szjuan/Micro_1/CódigosSistemaFinal/PreInforme_1__Freno_Pinza_.pdf

# Pre Informe (Freno Pinza)

Proyecto de Diseno en Mecatr ˜ | ónica

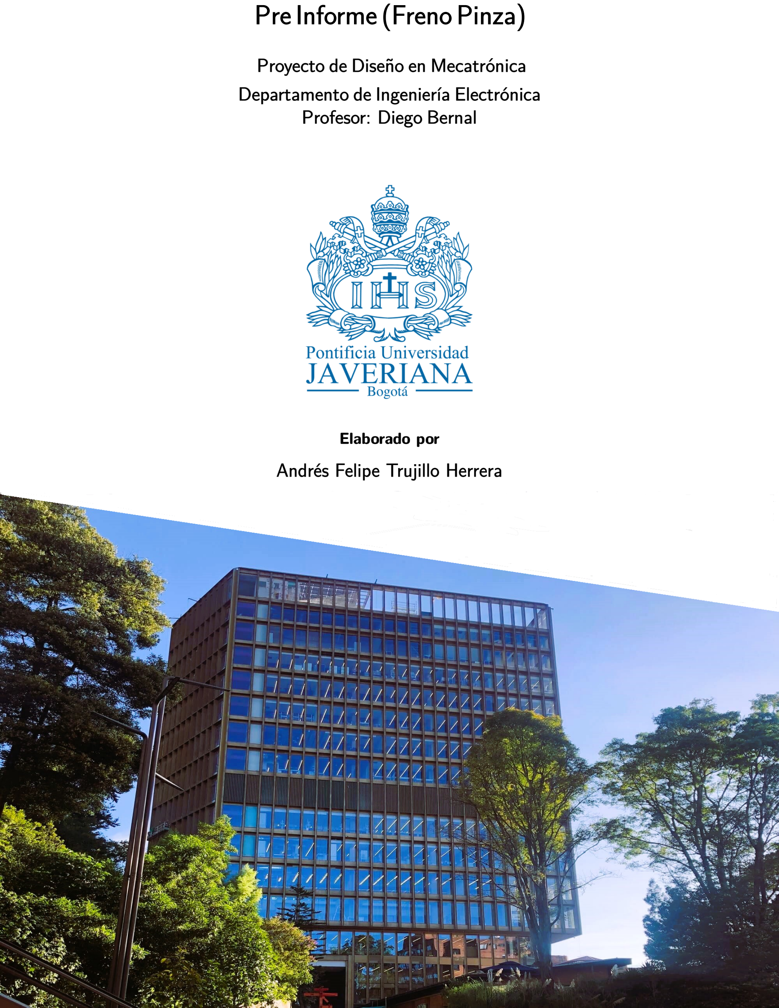
[picture p1: page 1]

## Departamento de Ingeniería Electrónica Profesor: Diego Bernal

Elaborado por

## Andrés Felipe Trujillo Herrera

Pre Informe (Freno Pinza)

## 1 | Introducción

Los motores Brushless DC (BLDC) son utilizados en diferentes aplicaciones mecatrónicas debido a su eficiencia, buena respuesta dinámica y bajo desgaste mecánico. Sin embargo, para seleccionar y utilizar correctamente uno de estos motores es necesario conocer su comportamiento ante diferentes condiciones de operación, especialmente cuando se aplican cargas sobre su eje.

En este proyecto se busca caracterizar un motor 57BLDC mediante la obtención de su modelo matemático y el análisis de variables como la velocidad, la corriente, el torque, la potencia y la eficiencia. Inicialmente, el comportamiento del motor será representado mediante un modelo electromecánico y un diagrama de bloques, los cuales serán implementados en Simulink para observar la respuesta del sistema ante distintos valores de carga.

Posteriormente, se diseñará un sistema experimental que permita aplicar torque resistente de forma controlada. Para ello, se propone un freno de disco tipo pinza, el cual generará una fuerza de fricción opuesta al movimiento del motor. La reacción producida por el frenado será medida mediante un sistema basado en galgas extensiométricas, permitiendo determinar el torque aplicado durante cada prueba.

1.1 | Planteamiento del problema

Para determinar las características reales de un motor no es suficiente con ponerlo en funcionamiento sin carga, ya que su velocidad, corriente y eficiencia cambian cuando aumenta el torque requerido en el eje. Por esta razón, se necesita un sistema que permita aplicar diferentes niveles de carga de manera gradual, estable y repetible, sin comprometer la integridad del motor ni la seguridad del montaje.

Además de aplicar la carga, es necesario medir correctamente el torque generado por el sistema de frenado y relacionarlo con las demás variables eléctricas y mecánicas del motor. La señal obtenida mediante una galga extensiométrica es de baja amplitud, por lo que requiere una etapa de acondicionamiento, adquisición y procesamiento antes de poder ser interpretada.

También se requiere una forma organizada de transmitir y visualizar los datos obtenidos durante las pruebas. Por esta razón, el proyecto debe integrar el sistema mecánico de frenado con un sistema electrónico y de comunicación que permita consultar las mediciones en tiempo real desde otro computador.

1.2 | Solución propuesta

Como solución se planteó el diseño de un banco de pruebas para caracterizar el motor 57BLDC mediante un sistema de frenado mecánico tipo pinza. El disco se acopla al eje del motor y la carga se regula manualmente mediante un mecanismo roscado que aproxima ambas partes de la pinza, aumentando progresivamente la fuerza de fricción y el torque resistente.

El torque se determina a partir de la reacción mecánica de la pinza sobre una celda de carga instrumentada con galgas extensiométricas. La señal es adquirida mediante un módulo HX711 y procesada por un ESP32, mientras que la velocidad se obtiene a partir del pin S del driver ZS-X11H. Ambas variables son enviadas mediante MQTT hacia un broker y posteriormente recibidas por un programa desarrollado en Python.

De forma paralela, Python se comunica con la fuente programable mediante Keysight IO Libraries y PyVISA para obtener los valores de voltaje y corriente y controlar las condiciones de alimentación. De esta forma se centralizan las variables:

V, | I, | n, | Fm, | (1.1)

a partir de las cuales se calculan la velocidad angular, el torque de carga, la potencia y la eficiencia. Los datos se almacenan continuamente para analizar tanto el comportamiento transitorio como las condiciones de estado estacionario y generar posteriormente las curvas características del motor.

1.3 Alcance del proyecto | Pre Informe (Freno Pinza)
1.3 | Alcance del proyecto

El proyecto comprende el modelado matemático equivalente del motor 57BLDC, su representación mediante un diagrama de bloques y la simulación de su respuesta en MATLAB ante variaciones de voltaje y torque de carga. También incluye el diseño mecánico del sistema de frenado tipo pinza, los cálculos principales, la selección de materiales y la elaboración de los planos de fabricación.

Además, se plantea el sistema de medición de fuerza mediante una celda de carga, un módulo HX711 y un ESP32, junto con la obtención de la velocidad desde el driver ZS-X11H. Las variables eléctricas se adquieren desde la fuente programable mediante PyVISA, mientras que los datos del ESP32 se transmiten por MQTT hacia un computador para su procesamiento en Python.

Finalmente, se establece el protocolo de medición necesario para obtener las curvas características y analizar tanto el comportamiento estacionario como transitorio del motor, dejando definida la base para la posterior fabricación, calibración y validación experimental del banco de pruebas.

## 2 | Objetivos

2.1 | Objetivo general

Diseñar un banco de pruebas para la caracterización de un motor 57BLDC, utilizando un sistema de frenado tipo pinza que permita aplicar diferentes niveles de torque resistente y medir las principales variables eléctricas y mecánicas del sistema para analizar su comportamiento en estado estacionario y transitorio.

2.2 | Objetivos específicos

■ Determinar los parámetros eléctricos y mecánicos necesarios para construir el modelo matemático equivalente del motor 57BLDC.

■ Representar el comportamiento dinámico del motor mediante sus ecuaciones, un diagrama de bloques y simulaciones desarrolladas en MATLAB ante variaciones de voltaje y torque de carga.

■ Diseñar el sistema mecánico de frenado tipo pinza, incluyendo el disco, el mecanismo de ajuste, los soportes y el sistema de medición del torque.

■ Implementar y calibrar el sistema de medición de fuerza mediante una celda de carga, un módulo HX711 y una ESP32, con el fin de obtener el torque resistente aplicado al motor.

■ Obtener la velocidad del motor a partir del driver ZS-X11H y adquirir las variables eléctricas de la fuente programable mediante Keysight IO Libraries y PyVISA.

■ Desarrollar un sistema de adquisición y procesamiento en Python que integre los datos recibidos mediante MQTT y PyVISA, permitiendo calcular torque, velocidad angular, potencia y eficiencia.

■ Establecer un protocolo experimental para obtener las curvas características del motor y analizar su respuesta bajo diferentes condiciones de alimentación y carga de manera segura y repetible.

## 3 | Marco teórico

3.1 | Motores de corriente continua

Los motores de corriente continua, también conocidos como motores DC, son máquinas eléctricas que convierten energía eléctrica en movimiento rotacional. Su funcionamiento se basa en la interacción entre un campo magnético y la corriente que circula por los conductores del motor, produciendo una fuerza electromagnética que genera torque sobre el eje [1].

En un motor DC convencional, el estator genera el campo magnético y el rotor o armadura corresponde a la parte giratoria. La conmutación de la corriente se realiza mecánicamente mediante escobillas y un conmutador, permitiendo mantener el giro del rotor en una misma dirección.

3.2 Motores Brushless DC | Pre Informe (Freno Pinza)

Entre sus componentes principales se encuentran:

■ El estator, encargado de producir el campo magnético.

■ El rotor o armadura, que corresponde a la parte giratoria.

■ El eje, encargado de transmitir el movimiento mecánico.

■ Las escobillas y el conmutador, utilizados para realizar la conmutación eléctrica.

■ Los rodamientos, que permiten el giro del eje con menor fricción.

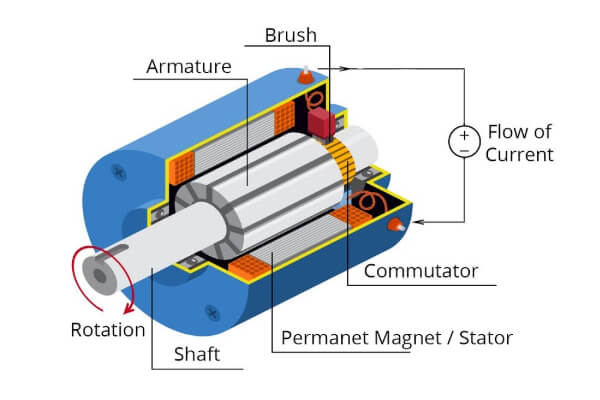
[picture p2: figure]

Figure 3.1: Partes principales de un motor de corriente continua.

Durante el funcionamiento del motor existe una relación directa entre sus variables eléctricas y mecánicas. La corriente que circula por los devanados produce torque, mientras que el movimiento del rotor genera una fuerza contraelectromotriz que se opone al voltaje de alimentación. Estas relaciones permiten representar matemáticamente el comportamiento del motor.

3.2 | Motores Brushless DC

Los motores Brushless DC (BLDC) son motores de corriente continua que no utilizan escobillas para realizar la conmutación. En su lugar, emplean un controlador electrónico que energiza las fases del estator en una secuencia determinada [2, 3].

Un motor BLDC está compuesto principalmente por un estator con devanados, un rotor con imanes permanentes y un controlador o driver. El controlador determina las fases que deben energizarse de acuerdo con la posición del rotor, generando el campo magnético necesario para mantener el movimiento.

La posición del rotor puede obtenerse mediante sensores Hall o estimarse a partir de la fuerza contraelectromotriz de las fases. En configuraciones con sensores Hall se utilizan comúnmente tres señales digitales que permiten determinar la posición eléctrica del rotor y establecer la secuencia de conmutación [3].

3.3 Características del motor 57BLDC | Pre Informe (Freno Pinza)

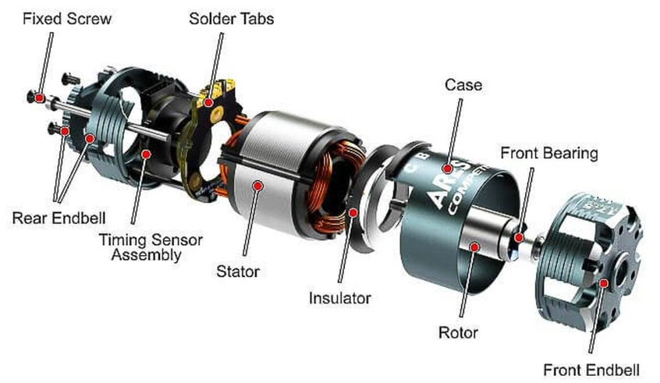
[picture p3: figure]

Figure 3.2: Estructura general y sistema de conmutación de un motor BLDC.

De forma general, para cada fase del motor puede escribirse:

vk(t) = Rsik(t) + Ls

dik(t)
dt | + ek(t), | k ∈ {a, b, c}, | (3.1)

donde vk, ik y ek corresponden al voltaje, la corriente y la fuerza contraelectromotriz de la fase k. Los parámetros Rs y Ls representan la resistencia y la inductancia de los devanados.

Para una conexión en estrella sin acceso al punto neutro, las corrientes de fase cumplen:

ia(t) + ib(t) + ic(t) = 0. | (3.2)

Los motores BLDC pueden presentar una fuerza contraelectromotriz de forma trapezoidal y utilizar una conmutación electrónica de seis pasos. Sin embargo, cuando el controlador se encarga de realizar la conmutación y se desea estudiar el comportamiento promedio del conjunto, es posible utilizar un modelo DC equivalente. Esta aproximación permite analizar variables como corriente, velocidad y torque sin representar individualmente la conmutación de cada fase [4, 2].

Entre las principales ventajas de este tipo de motor se encuentran su buena eficiencia, bajo mantenimiento, ausencia de desgaste por escobillas y buena relación entre torque y tamaño. Por estas características son utilizados en aplicaciones de automatización, robótica y sistemas mecatrónicos.

3.3 | Características del motor 57BLDC

El motor utilizado en el proyecto corresponde a la referencia 57BLDC75-20730, perteneciente a la familia 57BLDC. Este tipo de motor posee una brida de aproximadamente 57 mm y es utilizado en aplicaciones que requieren un motor compacto con control electrónico de velocidad y torque.

3.3 Características del motor 57BLDC | Pre Informe (Freno Pinza)

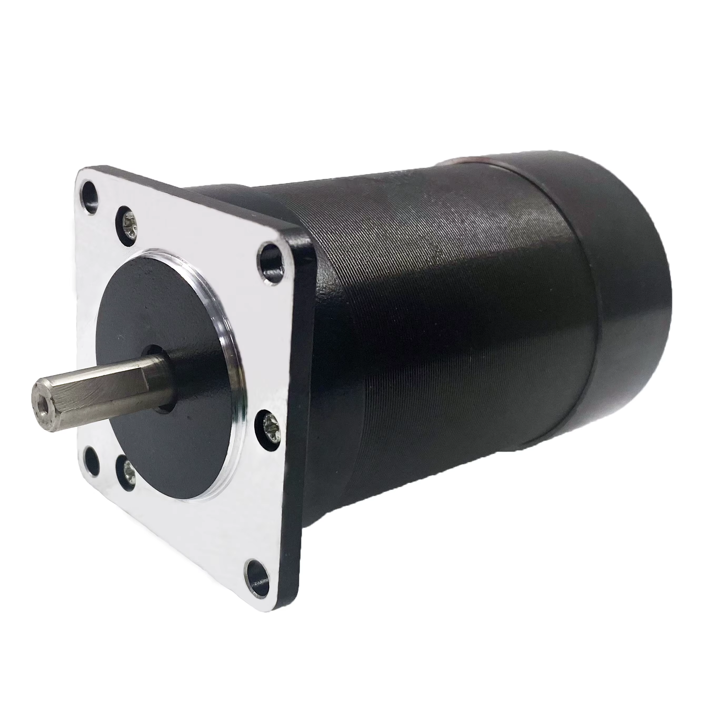
[picture p4: figure]

(a) Motor utilizado

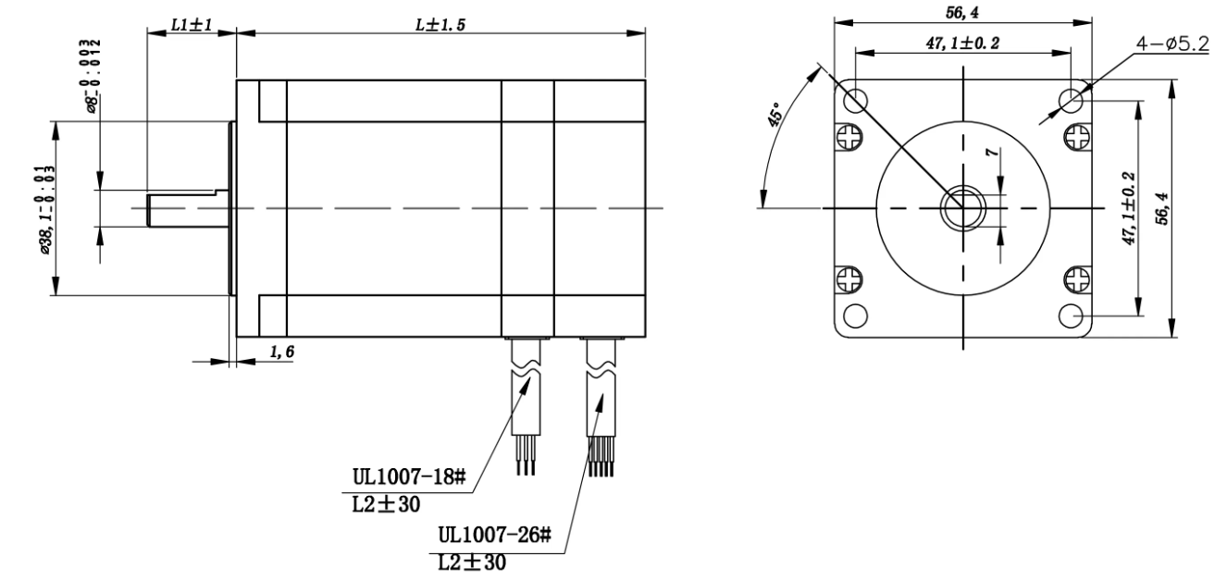
[picture p5: figure]

(b) Dimensiones principales

Figure 3.3: Motor 57BLDC seleccionado para el banco de pruebas y sus dimensiones principales.

Los principales datos nominales y parámetros iniciales utilizados para el análisis se presentan en la Tabla 3.1. Algunos parámetros que no se encuentran disponibles en la información principal del motor se consideran inicialmente como valores de referencia y posteriormente deberán verificarse mediante el procedimiento de identificación paramétrica.

Table 3.1: Datos nominales y parámetros iniciales del motor 57BLDC.

Parámetro | Símbolo | Valor
Referencia completa | — | 57BLDC75-20730
Voltaje nominal | Vn | 24 VDC
Potencia nominal | Pn | 70 W
Velocidad nominal | nn | 3000 RPM
Velocidad sin carga | n0 | 4000 RPM
Torque nominal | Tn | 0.22 N m
Corriente nominal | In | 4 A
Número de fases | m | 3
Número de pares de polos | p | 4
Resistencia entre líneas | R | 0.48 Ω
Inductancia entre líneas | L | 0.45 mH
Constante de torque | Kt | 0.055 N m/A
Constante de Back-EMF | Ke | 3.36 Vrms/krpm
Momento de inercia | J | 1.48 × 10⁻⁵ kg m²

La velocidad del motor puede expresarse en revoluciones por minuto (RPM) o en radianes por segundo. La conversión entre estas unidades está dada por:

ω =

2πn
60
, | (3.3)

donde n corresponde a la velocidad en RPM y ω a la velocidad angular en rad/s.

3.4 Modelo electromecánico de un motor DC | Pre Informe (Freno Pinza)
3.4 | Modelo electromecánico de un motor DC

Para analizar el comportamiento promedio del motor BLDC se utilizará un modelo DC equivalente. Este modelo representa la interacción entre la parte eléctrica del motor y la dinámica mecánica del eje, mientras que el controlador electrónico se encarga de realizar la conmutación de las fases.

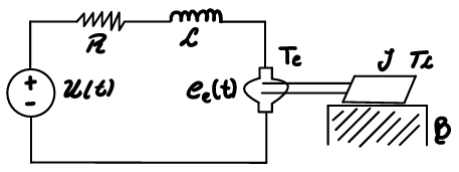
[picture p6: figure]

Figure 3.4: Circuito equivalente electromecánico del motor.

Aplicando la ley de voltajes de Kirchhoff al circuito equivalente, la ecuación eléctrica puede expresarse como:

V (t) = L

di(t)
dt + Ri(t) + eb(t), | (3.4)

donde V (t) es el voltaje aplicado, R y L representan la resistencia y la inductancia equivalentes, e i(t) corresponde a la corriente.

La fuerza contraelectromotriz generada por el movimiento del rotor es proporcional a la velocidad angular:

eb(t) = Keω(t), | (3.5)

donde Ke es la constante de fuerza contraelectromotriz.

De manera similar, el torque electromagnético generado por el motor puede relacionarse con la corriente mediante:

Te(t) = Kti(t), | (3.6)

donde Kt corresponde a la constante de torque [5].

La dinámica mecánica del eje se obtiene mediante el balance de torques:

J

dω(t)
dt | = Te(t) − Bω(t) − TL(t), | (3.7)

donde J representa el momento de inercia equivalente, B el coeficiente de fricción viscosa y TL(t) el torque externo aplicado sobre el eje.

Al sustituir la relación entre corriente y torque, la ecuación mecánica queda:

J

dω(t)
dt | = Kti(t) − Bω(t) − TL(t). | (3.8)

3.5 Curvas características del motor | Pre Informe (Freno Pinza)

Estas ecuaciones representan el acoplamiento entre el comportamiento eléctrico y mecánico del motor. A partir de ellas se desarrollará posteriormente el modelo matemático utilizado para la simulación del sistema.

3.5 | Curvas características del motor

Las curvas características permiten observar cómo cambia el comportamiento del motor cuando aumenta la carga aplicada sobre el eje. Entre las relaciones más importantes se encuentran torque–velocidad, corriente–torque, potencia y eficiencia.

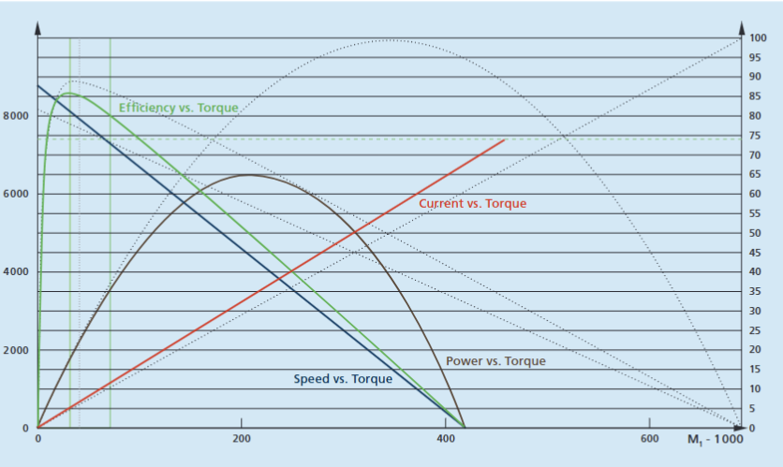
[picture p7: figure]

Figure 3.5: Curvas características típicas de un motor DC.

3.5.1 | Torque–velocidad

En condiciones de estado estable, las variaciones de corriente y velocidad pueden considerarse iguales a cero. A partir del modelo electromecánico se obtiene una relación aproximadamente lineal entre el torque de carga y la velocidad:

TL =

Kt
R

V −

KtKe
R

+ B

ω. | (3.9)

Esta expresión indica que, para un voltaje de alimentación determinado, la velocidad disminuye a medida que aumenta el torque resistente aplicado al eje. Por esta razón, la curva torque–velocidad es una de las principales características utilizadas para analizar el comportamiento de un motor.

3.5.2 | Corriente–torque

Como se observa en la Ecuación (3.6), el torque electromagnético es aproximadamente proporcional a la corriente del motor. Por lo tanto, cuando aumenta el torque requerido por la carga, el motor necesita una mayor corriente para mantener el movimiento.

En estado estable, el torque producido debe compensar tanto el torque aplicado por la carga como las pérdidas mecánicas:

Te = TL + Bω. | (3.10)

Esta relación permite utilizar la corriente como una variable importante para evaluar el comportamiento

3.6 Freno de disco tipo pinza | Pre Informe (Freno Pinza)

del motor bajo diferentes condiciones de carga.

3.5.3 | Potencia y eficiencia

La potencia mecánica entregada a una carga rotacional depende del torque y de la velocidad angular, y puede calcularse mediante:

Pm = TLω, | (3.11)

donde Pm corresponde a la potencia mecánica.

La potencia eléctrica suministrada al sistema puede determinarse a partir del voltaje y la corriente medidos en el bus de alimentación:

Pe = VdcIdc. | (3.12)

A partir de estas dos variables, la eficiencia se calcula mediante:

η =

Pm
Pe
× 100%. | (3.13)

Si el voltaje y la corriente se miden antes del controlador electrónico, la eficiencia obtenida corresponde al conjunto formado por el controlador y el motor, ya que también se incluyen las pérdidas presentes en el driver.

Dentro del modelo simplificado, una de las principales pérdidas eléctricas corresponde al calentamiento de los devanados debido a su resistencia:

PCu = Ri²
. | (3.14)

También pueden considerarse las pérdidas mecánicas asociadas a la fricción viscosa:

Pfr = Bω²
. | (3.15)

Estas pérdidas influyen en la potencia disponible en el eje y, por lo tanto, en la eficiencia del motor.

3.6 | Freno de disco tipo pinza
3.6.1 | Principio de funcionamiento

El freno de disco tipo pinza es un sistema utilizado para generar un torque resistente sobre un elemento en rotación. Está compuesto principalmente por un disco unido al eje y una pinza con dos pastillas de fricción ubicadas a ambos lados del disco [6].

Cuando las pastillas son presionadas contra las caras del disco, se genera una fuerza de fricción que se opone al movimiento. Como resultado aparece un torque resistente que disminuye la velocidad de rotación.

3.6 Freno de disco tipo pinza | Pre Informe (Freno Pinza)

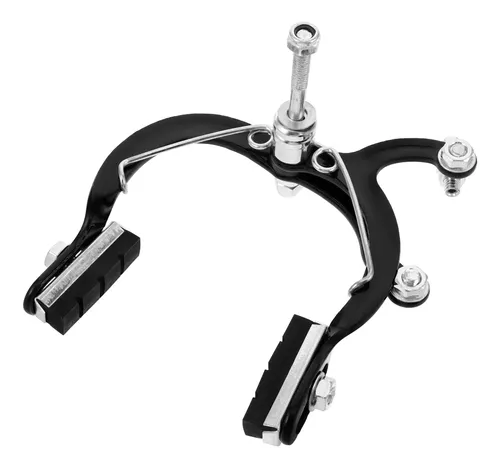
[picture p8: figure]

Figure 3.6: Esquema general de un freno de disco tipo pinza.

La capacidad de frenado depende principalmente de la fuerza normal aplicada sobre las pastillas, el coeficiente de fricción entre las superficies y la distancia entre la zona de contacto y el eje de rotación.

La utilización de dos pastillas permite actuar sobre ambas caras del disco, distribuyendo la fuerza de contacto y generando el torque de frenado.

3.6.2 | Fuerza de fricción y torque de frenado

La fuerza de fricción generada entre una pastilla y el disco puede aproximarse mediante:

Ff = µNp, | (3.16)

donde µ corresponde al coeficiente de fricción entre las superficies y Np a la fuerza normal ejercida por una pastilla.

El torque producido por una fuerza tangencial depende de la fuerza aplicada y de su distancia perpendicular respecto al eje de rotación:

T = Ff r, | (3.17)

donde r representa el radio de aplicación de la fuerza.

Considerando que las dos pastillas ejercen aproximadamente la misma fuerza normal, el torque total de frenado puede aproximarse mediante:

Tf = 2µNpref, | (3.18)

donde ref corresponde al radio efectivo sobre el cual actúa la fuerza de fricción.

Para un análisis inicial, si la zona de contacto está comprendida entre un radio interno ri y un radio externo ro, el radio efectivo puede aproximarse como:

ref ≈

ri + ro
2
. | (3.19)

Estas relaciones permiten estimar el torque generado por un freno de disco. Sin embargo, en condiciones reales el coeficiente de fricción puede variar debido a la temperatura, el desgaste, la presión y el estado de las superficies de contacto.

Pre Informe (Freno Pinza)

## 4 | Identificación, modelado y simulación del sistema

Para representar el comportamiento del motor 57BLDC se determinaron los parámetros eléctricos y mecánicos necesarios para construir un modelo DC equivalente. Algunos valores se obtuvieron directamente de la ficha técnica, mientras que otros se estimaron a partir de las condiciones nominales y de vacío del motor.

También se evaluaron los límites teóricos del modelo y posteriormente se incorporó la restricción de corriente de 1 A impuesta por el driver ZS-X11H. Con estos resultados se formuló el modelo matemático y se desarrollaron las simulaciones en MATLAB.

4.1 | Identificación de los parámetros del motor

Los parámetros considerados fueron R, L, Ke, Kt, B y J, los cuales permiten representar la dinámica eléctrica y mecánica del motor.

4.1.1 | Parámetros eléctricos

La resistencia y la inductancia equivalentes se tomaron directamente de la ficha técnica:

R = 0.48 Ω, | L = 0.45 mH. | (4.1)

La constante de fuerza contraelectromotriz se obtuvo utilizando la condición de vacío y la ecuación estacionaria:

V = RI0 + Keω0. | (4.2)

Para una velocidad sin carga de 4000 RPM:

ω0 = 4000
2π

60
= 418.88 rad/s. | (4.3)

Por lo tanto:

Ke =

V − RI0
ω0

=

24 − (0.48)(0.3)
418.88
, | (4.4)

obteniéndose:

Ke ≈ 0.05695 V s/rad | (4.5)
4.1.2 | Parámetros mecánicos

La constante de torque relaciona la corriente con el torque electromagnético:

Te = Kti. | (4.6)

En estado estacionario, el balance mecánico está dado por:

Kti = Bω + TL. | (4.7)

4.1 Identificación de los parámetros del motor | Pre Informe (Freno Pinza)

Para determinar Kt y B se utilizaron las condiciones de vacío y operación nominal:

KtI0 = Bω0, | KtIn = Bωn + Tn. | (4.8)

La velocidad nominal de 3000 RPM corresponde a ωn = 314.16 rad/s. Combinando ambas condiciones se obtuvo:

Kt =

Tn

In − I0

ωn
ω0
, | (4.9)

por lo que:

Kt ≈ 0.05828 N m/A | (4.10)

y posteriormente:

B =

KtI0
ω0
≈ 4.17 × 10⁻⁵ N m s/rad | (4.11)

El parámetro B representa de forma equivalente las pérdidas mecánicas dependientes de la velocidad. El punto nominal del fabricante (In = 4 A y Tn = 0.22 N m) se utilizó para la identificación, aunque no puede alcanzarse posteriormente con el driver limitado a 1 A.

El momento de inercia del rotor utilizado inicialmente fue:

Jrotor = 1.48 × 10⁻⁵
kg m²
. | (4.12)

Para las simulaciones que incluyen el disco de freno se utiliza posteriormente la inercia equivalente de todo el conjunto giratorio.

4.1.3 | Torque de bloqueo teórico y limitación del driver

En la condición de bloqueo se cumple ω = 0, por lo que la fuerza contraelectromotriz desaparece y la corriente teórica queda determinada por:

Istall =

V
R
. | (4.13)

Para V = 24 V y R = 0.48 Ω:

Istall = 50 A. | (4.14)

El torque de bloqueo ideal resulta entonces:

Tstall = KtIstall ≈ 2.91 N m | (4.15)

Este valor corresponde únicamente al modelo ideal del motor. En el banco de pruebas, el driver ZS-X11H limita la corriente a:

4.2 Modelo matemático del sistema | Pre Informe (Freno Pinza)
Imax = 1 A | (4.16)

por lo que el máximo torque electromagnético disponible bajo esta restricción es:

Te,max = KtImax ≈ 0.05828 N m. | (4.17)

Mientras el motor se encuentra girando, parte de este torque compensa las pérdidas mecánicas, por lo que:

TL = KtImax − Bω. | (4.18)

De esta manera, los 2.91 N m se conservan únicamente como referencia teórica, mientras que las simulaciones del banco consideran la limitación real de corriente.

4.1.4 | Resumen de parámetros identificados

Los parámetros utilizados posteriormente en el modelo se resumen en la Tabla 4.1.

Table 4.1: Parámetros del modelo equivalente del motor.

Parámetro | Valor | Unidad
R | 0.48 | Ω
L | 0.45 × 10⁻³ | H
Ke | 0.05695 | V s/rad
Kt | 0.05828 | N m/A
B | 4.17 × 10⁻⁵ | N m s/rad
Jrotor | 1.48 × 10⁻⁵ | kg m²
Imax | 1 | A
4.2 | Modelo matemático del sistema

El motor BLDC se representó mediante un modelo DC equivalente, considerando que el controlador electrónico realiza la conmutación de las fases. Las entradas del modelo son el voltaje aplicado V (t) y el torque resistente TL(t), mientras que las principales variables de respuesta son la corriente i(t) y la velocidad angular ω(t).

4.2.1 | Ecuaciones eléctrica y mecánica

La dinámica eléctrica se representa mediante:

V (t) = L

di(t)
dt + Ri(t) + Keω(t), | (4.19)

de donde:

di(t)
dt =

V (t) − Ri(t) − Keω(t)
L

(4.20)

Por otra parte, el balance de torques sobre el eje está dado por:

J

dω(t)
dt | = Kti(t) − Bω(t) − TL(t), | (4.21)

4.3 Representación mediante diagrama de bloques | Pre Informe (Freno Pinza)

por lo que:

dω(t)
dt =

Kti(t) − Bω(t) − TL(t)
J

(4.22)

Estas dos ecuaciones describen la dinámica electromecánica del motor. Durante las simulaciones se incorpora adicionalmente la restricción de corriente establecida previamente para el driver.

4.2.2 | Representación en variables de estado

Se definieron como estados la corriente y la velocidad angular:

x(t) =
i(t)
ω(t)

, u(t) =
V (t)
TL(t)
. | (4.23)

El modelo puede expresarse como:

x˙(t) = Ax(t) + Bu(t), | (4.24)

con:

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
- , B =

1
L

0

0 −

1
J

- . | (4.25)

Por lo tanto:
"
˙i(t)

ω˙(t)

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
i(t)

ω(t)

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
V (t)

TL(t)

. | (4.26)

Como salidas se consideraron directamente i(t) y ω(t), por lo que C = I y D = 0.

La formulación anterior representa el modelo lineal propio del motor. La limitación de corriente del driver no modifica estas matrices, sino que se incorpora posteriormente durante la solución numérica.

4.3 | Representación mediante diagrama de bloques

A partir de las ecuaciones 4.20 y 4.22 se construyó el diagrama de bloques de la Fig. 4.1. En este se observan las entradas V (t) y TL(t), la realimentación producida por la fuerza contraelectromotriz Keω y la generación del torque electromagnético a partir de la corriente mediante Kt.

4.4 Implementación numérica del modelo en MATLAB | Pre Informe (Freno Pinza)

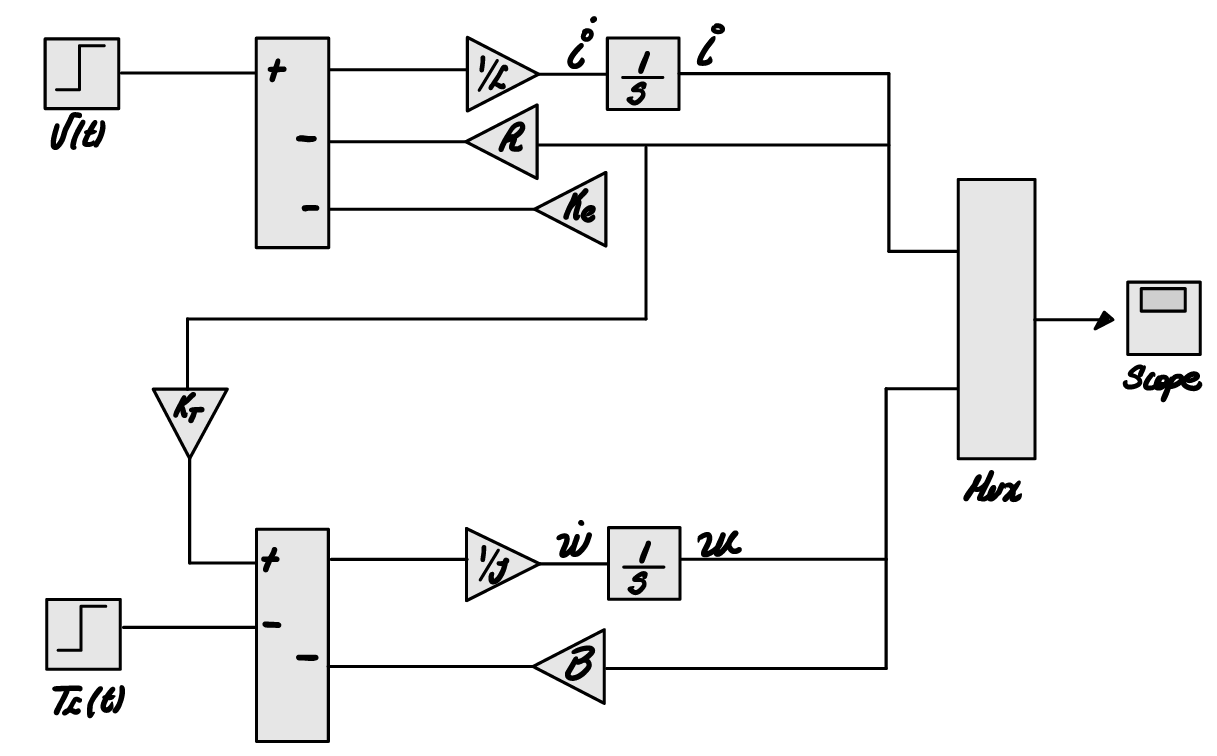
[picture p9: figure]

Figure 4.1: Diagrama de bloques del modelo equivalente del motor.

El diagrama se utilizó como representación conceptual del sistema, mientras que la solución de las ecuaciones y la incorporación de la limitación de corriente se realizaron directamente en MATLAB.

4.4 | Implementación numérica del modelo en MATLAB

Las ecuaciones diferenciales del modelo se implementaron en MATLAB y se resolvieron mediante ode45, integrando simultáneamente la corriente y la velocidad angular.

Durante la solución numérica se incorporó la restricción del driver:

0 ≤ i(t) ≤ 1 A, | (4.27)

de manera que, cuando el modelo intenta superar este valor, se representa la acción del sistema de accionamiento limitando la corriente.

Los parámetros empleados fueron los resumidos en la Tabla 4.1. Para las simulaciones que consideran únicamente el motor se utilizó Jrotor, mientras que para el análisis con el disco instalado se empleó la inercia equivalente del conjunto giratorio.

4.4.1 | Escenarios de simulación

El análisis se dividió en tres casos principales:

1. Curvas características en estado estacionario, considerando ˙i = 0 y ˙ω = 0.
2. Respuesta transitoria ante incrementos de voltaje desde 6 V hasta 24 V en pasos de 2 V cada 30 s, sin torque de carga externo.
3. Respuesta transitoria ante incrementos del torque de carga, manteniendo el voltaje constante y utilizando la inercia equivalente del conjunto rotor–disco–acople.

En todos los casos se mantuvo activa la limitación de corriente de 1 A para representar las condiciones de operación del banco de pruebas.

4.5 Resultados de simulación | Pre Informe (Freno Pinza)
4.5 | Resultados de simulación

Los resultados se analizaron mediante curvas características en estado estacionario y respuestas transitorias ante cambios de voltaje y torque de carga. En todos los casos se consideró la restricción de corriente del driver.

4.5.1 | Curvas características en estado estacionario

En estado estacionario se cumple:

˙i = 0, | ω˙ = 0. | (4.28)

Antes de alcanzar la limitación de corriente, las relaciones entre torque, velocidad y corriente son:

ω(TL) = KtV − RTL
KtKe + RB , | i(TL) = BV + KeTL
KtKe + RB . | (4.29)

Cuando la corriente alcanza Imax = 1 A, esta permanece limitada y la velocidad queda determinada por:

ω(TL) = KtImax − TL
B
. | (4.30)

Para 24 V, la limitación comienza aproximadamente en TL = 0.0411 N m, mientras que para 6 V aparece alrededor de 0.0542 N m. El torque límite correspondiente a ω = 0 e I = 1 A es aproximadamente 0.05828 N m. Por esta razón, el punto nominal del fabricante de 0.22 N m no puede alcanzarse con el driver utilizado.

La potencia mecánica y la eficiencia se calcularon mediante:

Pm = TLω, η =

Pm
Pe
× 100. | (4.31)

En la región de corriente limitada se consideró el voltaje efectivo requerido para mantener Imax:

Vef = RImax + Keω. | (4.32)

La Fig. 4.2 presenta la corriente y la velocidad en función del torque resistente.

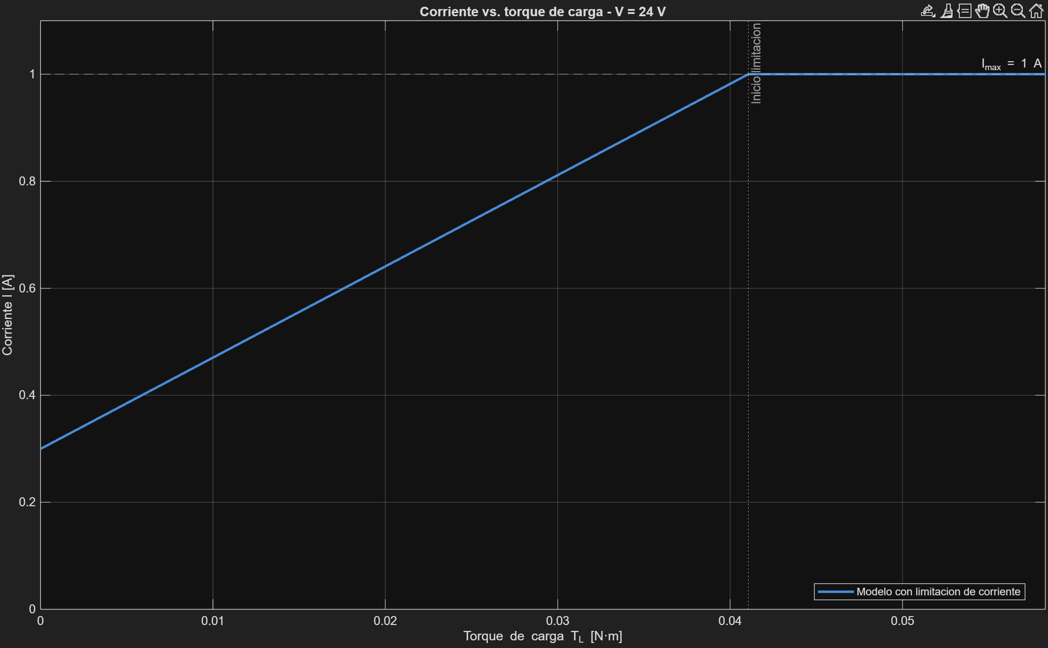
[picture p10: figure]
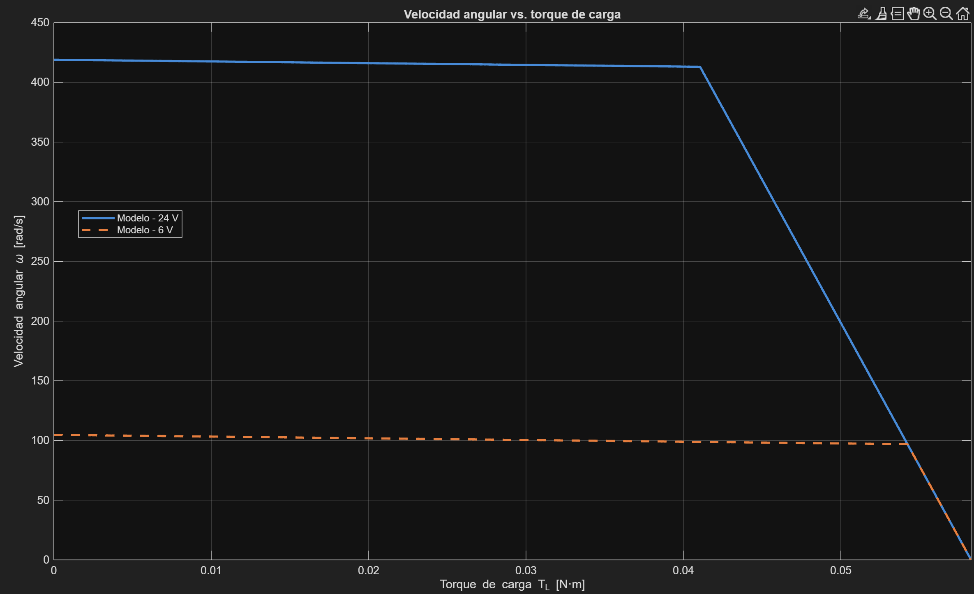
[picture p11: figure]

(a) Corriente vs. torque de carga. | (b) Velocidad angular vs. torque de carga.

Figure 4.2: Comportamiento de la corriente y la velocidad angular en función del torque de carga considerando la limitación del driver.

4.5 Resultados de simulación | Pre Informe (Freno Pinza)

En la Fig. 4.2(a), para 24 V, la corriente aumenta desde aproximadamente 0.30 A en vacío hasta alcanzar 1 A cerca de TL = 0.0411 N m. A partir de este punto permanece limitada, por lo que el motor ya no puede compensar cargas mayores aumentando la corriente.

La Fig. 4.2(b) muestra que, para 24 V, la velocidad parte de aproximadamente 419 rad/s (4000 RPM) y disminuye ligeramente mientras existe margen de corriente. Después de alcanzar el límite, la caída de velocidad se vuelve mucho más pronunciada hasta llegar a cero cerca de 0.05828 N m.

Para 6 V, la velocidad inicial es cercana a 105 rad/s (1000 RPM) y la limitación aparece a un torque mayor, aproximadamente 0.0542 N m. Una vez ambos casos quedan limitados a 1 A, las curvas siguen la misma relación mecánica y convergen hacia el mismo torque límite.

La Fig. 4.3 presenta la potencia mecánica y la eficiencia estimada para 24 V.

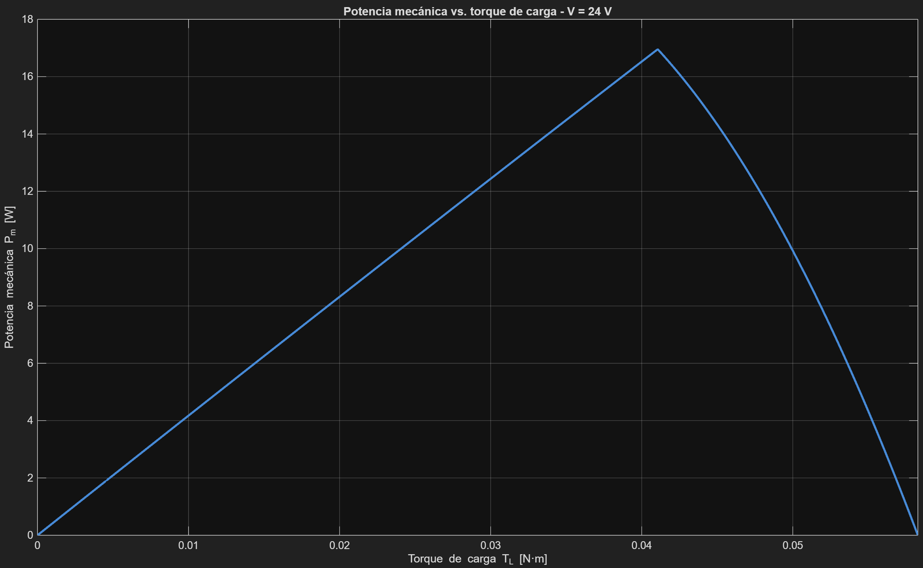
[picture p12: figure]
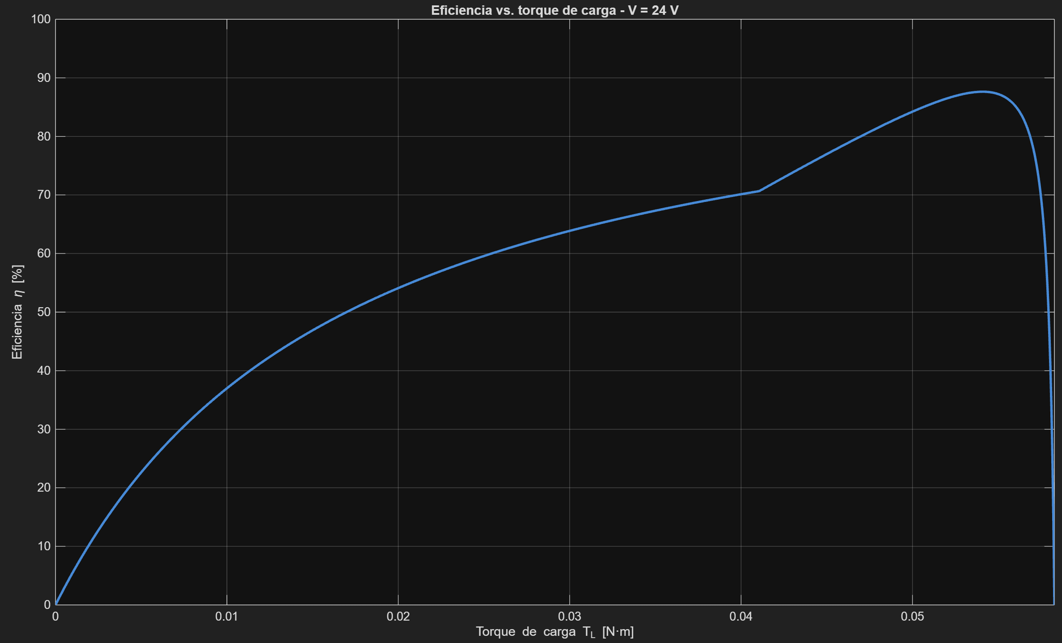
[picture p13: figure]

(a) Potencia mecánica vs. torque. | (b) Eficiencia vs. torque.

Figure 4.3: Potencia mecánica y eficiencia estimada para V = 24 V considerando la limitación de corriente.

La potencia mecánica parte de cero en condición sin carga y aumenta hasta un máximo aproximado de 16.95 W cerca de TL = 0.0411 N m, punto que coincide prácticamente con el inicio de la limitación. Después, la corriente no puede continuar aumentando y la reducción de velocidad provoca que la potencia disminuya hasta cero cuando el eje se detiene.

La eficiencia aumenta inicialmente con la carga y alcanza aproximadamente 87.6% alrededor de TL = 0.0541 N m. Posteriormente disminuye rápidamente debido a la caída de velocidad. Este valor corresponde a una estimación del modelo y no incluye pérdidas adicionales de la electrónica ni del banco, por lo que experimentalmente pueden obtenerse valores menores.

La Fig. 4.4 permite comparar de forma normalizada las principales variables para 24 V.

4.5 Resultados de simulación | Pre Informe (Freno Pinza)

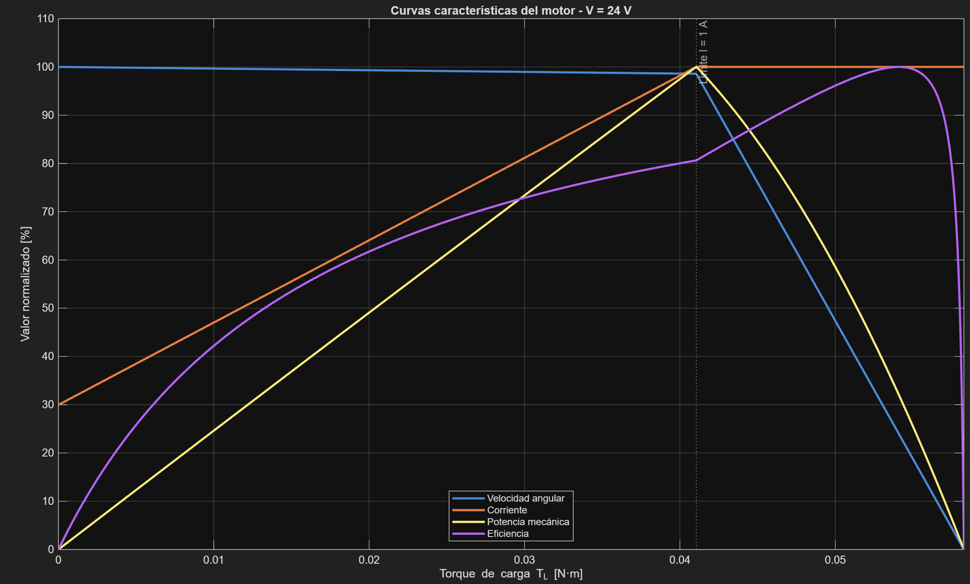
[picture p14: figure]

Figure 4.4: Curvas características normalizadas del motor para V = 24 V considerando una corriente máxima de 1 A.

La gráfica permite identificar claramente dos regiones. Antes de TL ≈ 0.0411 N m, la corriente aumenta mientras la velocidad se mantiene relativamente alta y la potencia mecánica crece. Después de alcanzar 1 A, la corriente permanece constante y los incrementos adicionales de carga producen principalmente una reducción de la velocidad y, posteriormente, de la potencia.

La eficiencia continúa aumentando durante parte de esta segunda región antes de disminuir cerca de la condición de bloqueo. Los valores normalizados permiten comparar las tendencias de las variables en una misma escala, por lo que el 100% de cada curva representa su máximo dentro del rango analizado y no necesariamente un valor físico del 100%.

En conjunto, los resultados muestran que el límite de corriente del driver determina el rango de operación disponible del banco y explica el cambio de comportamiento observado aproximadamente a partir de 0.0411 N m.

4.5.2 | Respuesta transitoria ante variaciones de voltaje

Para estudiar la respuesta dinámica del motor ante cambios en la alimentación, se realizó una simulación sin torque de carga externo:

TL = 0. | (4.33)

El voltaje comenzó en 6 V y aumentó en pasos de 2 V cada 30 s hasta alcanzar 24 V:

4.5 Resultados de simulación | Pre Informe (Freno Pinza)

V (t) =

6 V, | 0 ≤ t < 30,
8 V, | 30 ≤ t < 60,
10 V, 60 ≤ t < 90,
12 V, 90 ≤ t < 120,
14 V, 120 ≤ t < 150,
16 V, 150 ≤ t < 180,
18 V, 180 ≤ t < 210,
20 V, 210 ≤ t < 240,
22 V, 240 ≤ t < 270,
24 V, 270 ≤ t ≤ 300.

(4.34)

Para esta prueba se utilizó únicamente la inercia del rotor:

J = 1.48 × 10⁻⁵
kg m²
, | (4.35)

y se incorporó la limitación de corriente del driver:

i(t) ≤ 1 A. | (4.36)

Las ecuaciones diferenciales se resolvieron numéricamente en MATLAB mediante ode45. Los resultados principales de la prueba se presentan en la Fig. 4.5.

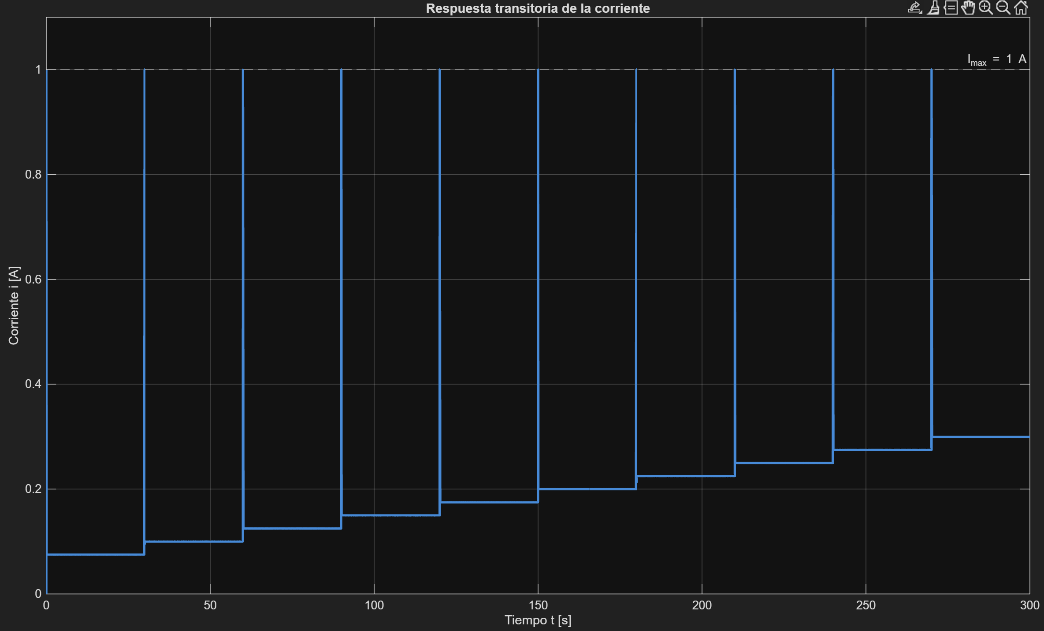
[picture p15: figure]
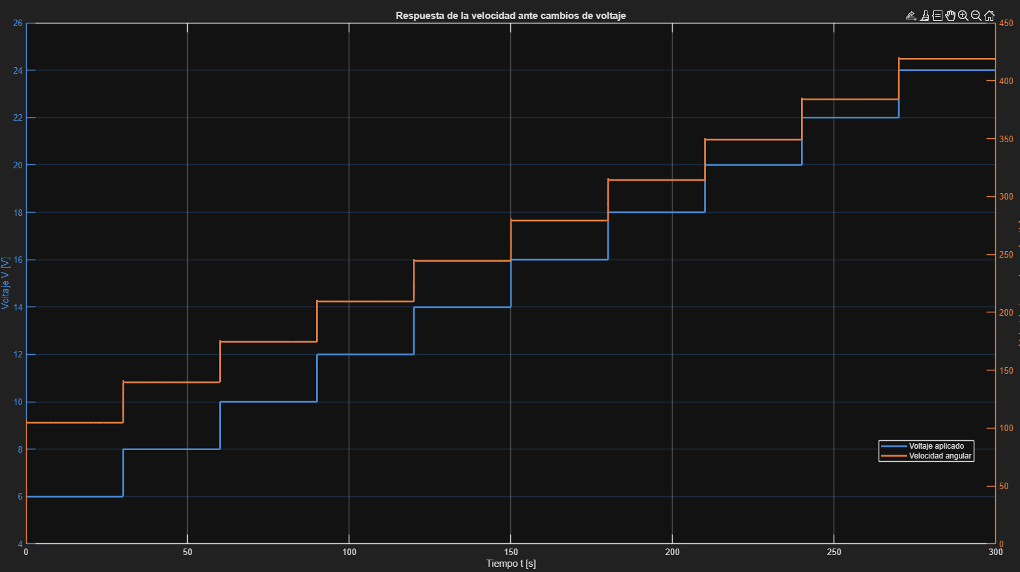
[picture p16: figure]

(a) Voltaje aplicado y velocidad angular. | (b) Corriente del motor.

Figure 4.5: Respuesta transitoria ante incrementos del voltaje: (a) voltaje aplicado y velocidad angular, y (b) corriente del motor considerando el límite de 1 A.

En la Fig. 4.5(a) se observa que cada incremento de 2 V produce un aumento correspondiente en la velocidad del motor. Para 6 V se alcanza aproximadamente 105 rad/s, equivalente a 1000 RPM, mientras que para 24 V la velocidad llega a cerca de 419 rad/s, aproximadamente 4000 RPM.

La relación entre voltaje y velocidad es prácticamente proporcional en condición sin carga. Además, debido a la baja inercia del rotor, cada cambio de velocidad ocurre rápidamente en comparación con los 30 s disponibles entre escalones, por lo que la respuesta presenta una apariencia casi escalonada.

Por otra parte, la Fig. 4.5(b) muestra que al iniciar el motor y después de cada incremento de voltaje aparece un aumento rápido de corriente hasta alcanzar el límite:

Imax = 1 A. | (4.37)

4.5 Resultados de simulación | Pre Informe (Freno Pinza)

Una vez aumenta la velocidad, también aumenta la fuerza contraelectromotriz y la corriente disminuye rápidamente hasta alcanzar un nuevo valor estacionario. Estos valores se encuentran aproximadamente entre 0.075 A para 6 V y 0.30 A para 24 V.

Por lo tanto, la limitación de 1 A actúa principalmente durante los transitorios producidos por el arranque y los cambios de voltaje, pero no afecta de forma permanente la operación sin carga. En conjunto, los resultados muestran que la velocidad sigue de manera estable los incrementos de alimentación, mientras que el driver evita que los aumentos rápidos de corriente superen el límite establecido.

4.5.3 | Respuesta transitoria ante variaciones del torque de carga

Como segunda prueba dinámica se mantuvo el voltaje aplicado constante en 24 V y se incrementó progresivamente el torque resistente TL en intervalos de 30 s. Los valores utilizados fueron:

TL = {0, 0.01, 0.02, 0.03, 0.04, 0.045, 0.05, 0.055} N m. | (4.38)

En esta prueba se analizó principalmente el aumento de la corriente y la reducción de la velocidad producidos por el incremento de la carga, considerando además la limitación de corriente de 1 A impuesta por el driver.

A diferencia de la prueba anterior, se utilizó la inercia equivalente de todos los elementos que giran solidariamente con el eje:

Jeq = Jrotor + Jdisco + Jacople. | (4.39)

La inercia del rotor se obtuvo de los datos del motor, mientras que las inercias del disco y de las dos bridas se calcularon a partir de sus dimensiones CAD y considerando aluminio como material. Los valores obtenidos fueron:

Jrotor = 1.48 × 10⁻⁵
kg m²
,
Jdisco ≈ 2.748 × 10⁻⁴
kg m²
,
Jacople ≈ 1.50 × 10⁻⁷
kg m²

(4.40)

Por lo tanto:

Jeq ≈ 2.898 × 10⁻⁴
kg m²
(4.41)

El disco aporta la mayor parte de la inercia del conjunto, por lo que su incorporación hace que los cambios de velocidad sean más progresivos que en la simulación realizada únicamente con el rotor.

Las respuestas obtenidas para la velocidad y la corriente se presentan en la Fig. 4.6.

Pre Informe (Freno Pinza)

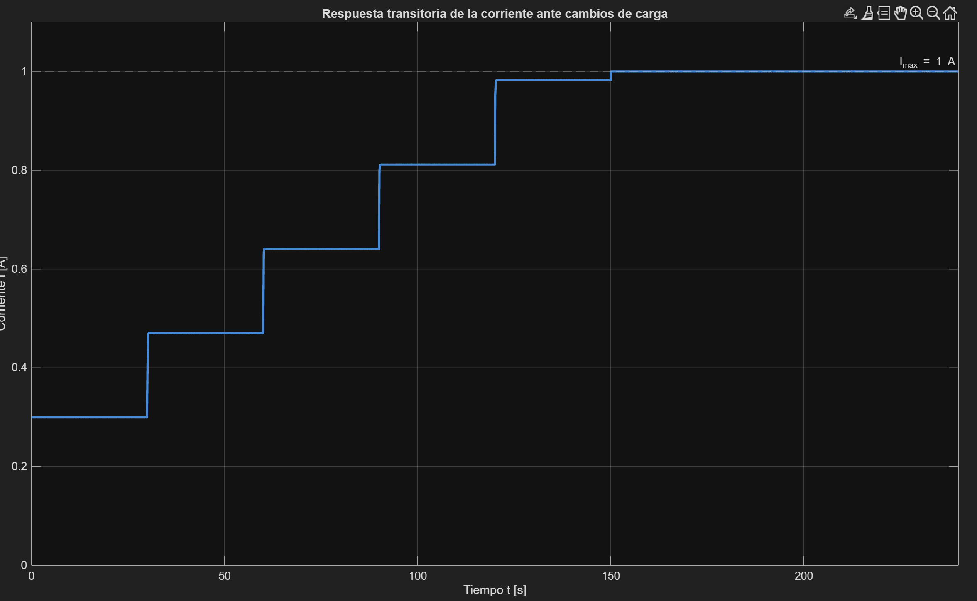
[picture p17: figure]
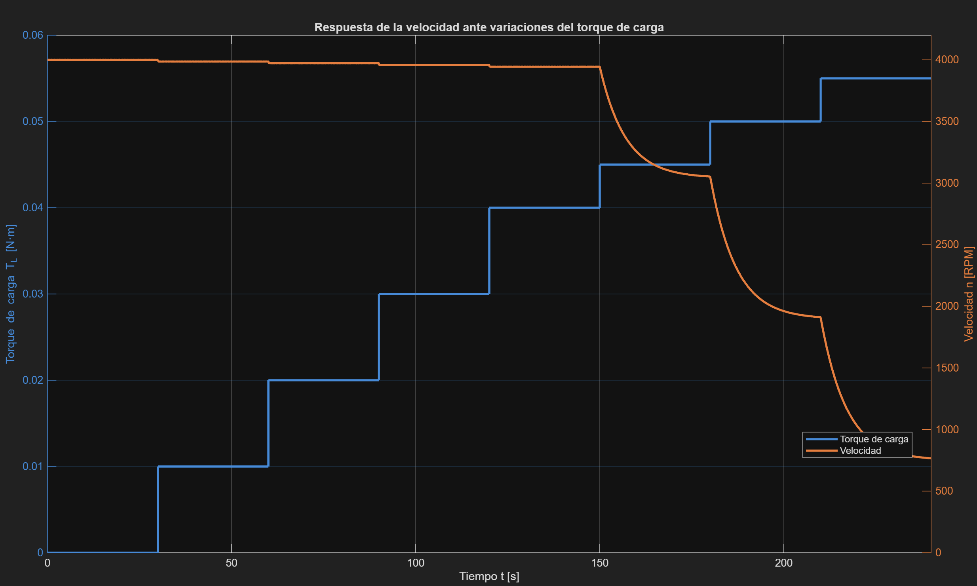
[picture p18: figure]

(a) Torque aplicado y velocidad del motor. | (b) Corriente del motor.

Figure 4.6: Respuesta transitoria ante incrementos del torque de carga: (a) torque aplicado y velocidad, y (b) corriente del motor.

En la Fig. 4.6(a) se observa que, para torques entre 0 y 0.04 N m, la velocidad disminuye únicamente de forma ligera y se mantiene cercana a 4000 RPM. Durante esta región el motor todavía puede compensar el aumento de carga incrementando la corriente.

A partir de TL = 0.045 N m se presenta una reducción mucho más marcada de la velocidad. Esta disminuye aproximadamente a 3040 RPM para 0.045 N m, 1900 RPM para 0.05 N m y 750 RPM para 0.055 N m. Además, debido a la mayor inercia del conjunto rotor–disco–acople, estas transiciones ocurren de manera progresiva hasta alcanzar el nuevo punto de operación.

La Fig. 4.6(b) permite explicar este cambio de comportamiento. La corriente aumenta aproximadamente desde 0.30 A en vacío hasta 0.98 A para TL = 0.04 N m. Al incrementar la carga a 0.045 N m se alcanza la limitación:

Imax = 1 A, | (4.42)

y la corriente permanece en este valor para los siguientes niveles de torque.

Por lo tanto, se identifican dos regiones de funcionamiento. Antes de alcanzar el límite de corriente, el motor compensa el incremento de carga aumentando la corriente y conservando una velocidad cercana a la de vacío. Una vez alcanzado 1 A, el torque electromagnético ya no puede seguir aumentando, por lo que los incrementos adicionales de carga producen principalmente una reducción de la velocidad. Este resultado muestra de forma clara cómo la limitación del driver determina el rango de operación disponible en el banco de pruebas.

## 5 | Diseño mecánico del sistema de medición

5.1 | Descripción general del sistema

El sistema mecánico diseñado tuvo como objetivo aplicar un torque de carga controlado al motor 57BLDC y, al mismo tiempo, permitir la medición de dicho torque durante las pruebas experimentales. Para ello se desarrolló un banco de pruebas compuesto principalmente por una base de soporte, el motor, un disco de frenado solidario al eje, una pinza mecánica de accionamiento manual y un sistema de medición basado en la deformación de un elemento instrumentado con galga extensiométrica.

La base del sistema se diseñó como una plataforma rectangular de aproximadamente 450 mm × 475 mm, sobre la cual se montaron tanto el motor como la estructura de la pinza y el soporte del sensor. El motor se ubicó en uno de los extremos del banco, mientras que el sistema de frenado se posicionó de manera alineada con el disco para garantizar un contacto adecuado entre las superficies de frenado.

El principio general de funcionamiento consiste en hacer girar el disco acoplado al eje del motor y aplicar

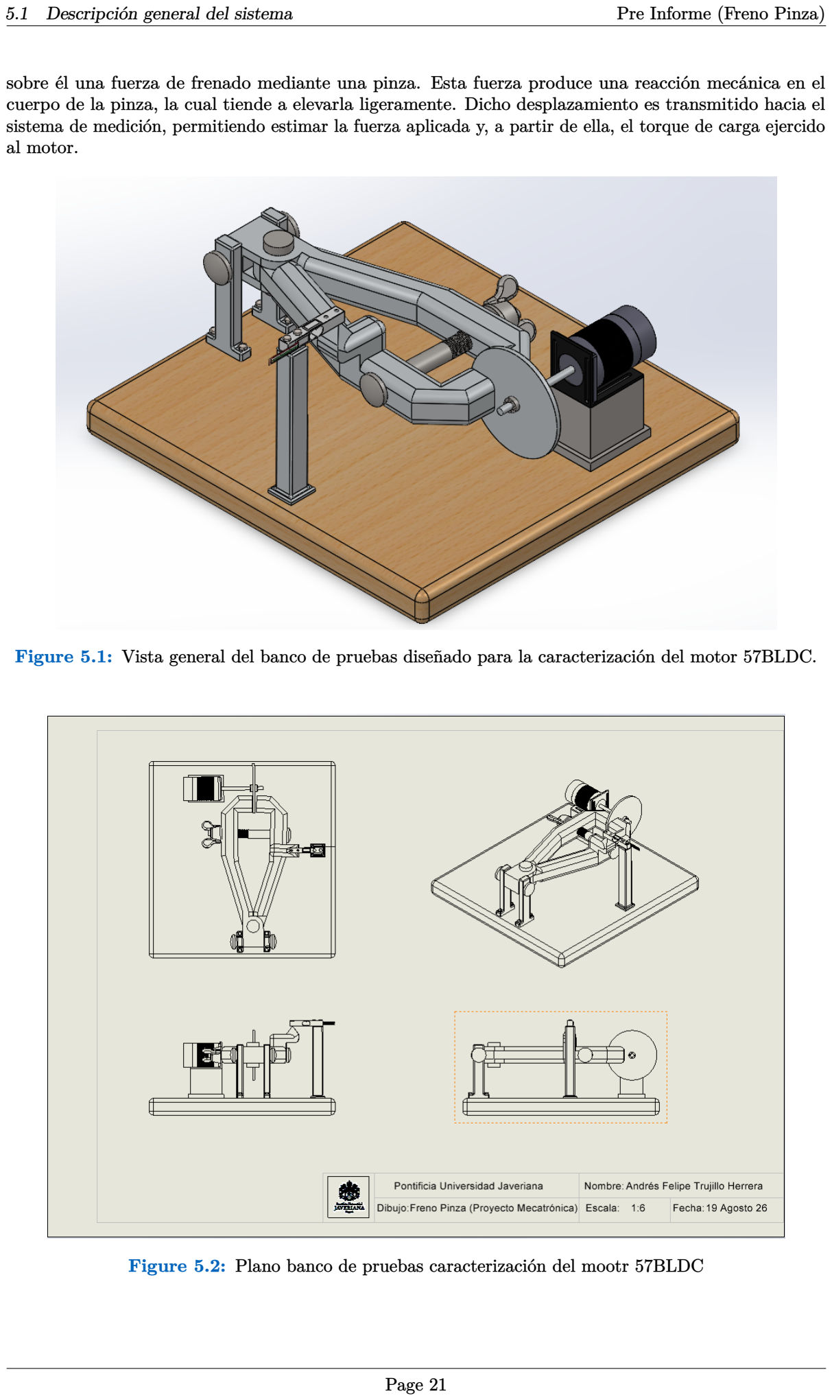
[picture p19: page 22]

5.1 Descripción general del sistema | Pre Informe (Freno Pinza)

sobre él una fuerza de frenado mediante una pinza. Esta fuerza produce una reacción mecánica en el cuerpo de la pinza, la cual tiende a elevarla ligeramente. Dicho desplazamiento es transmitido hacia el sistema de medición, permitiendo estimar la fuerza aplicada y, a partir de ella, el torque de carga ejercido al motor.

Figure 5.1: Vista general del banco de pruebas diseñado para la caracterización del motor 57BLDC.

Figure 5.2: Plano banco de pruebas caracterización del mootr 57BLDC

5.2 Diseño del disco de freno | Pre Informe (Freno Pinza)
5.2 | Diseño del disco de freno

El disco de freno se diseñó como un elemento circular sólido de aluminio, encargado de recibir directamente la acción de la pinza y transmitir el torque de frenado al eje del motor. De acuerdo con el plano realizado, el disco posee un diámetro exterior de:

D = 120 mm, | (5.1)

y un espesor de:

e = 5 mm. | (5.2)

Por lo tanto, su radio exterior es:

ro = 60 mm. | (5.3)

El disco fue diseñado para unirse al eje mediante dos bridas, una ubicada a cada lado del disco, formando un montaje tipo sándwich. Estas bridas permiten mantener el disco centrado y fijo respecto al eje, además de facilitar su montaje y desmontaje. La unión entre las dos bridas y el disco se planteó mediante cuatro tornillos distribuidos uniformemente, uno en cada cuadrante, de métrica M2.

Este arreglo permite una distribución simétrica de la sujeción, lo cual ayuda a reducir desalineaciones y facilita que el torque se transmita de manera más uniforme desde el disco hasta el eje del motor.

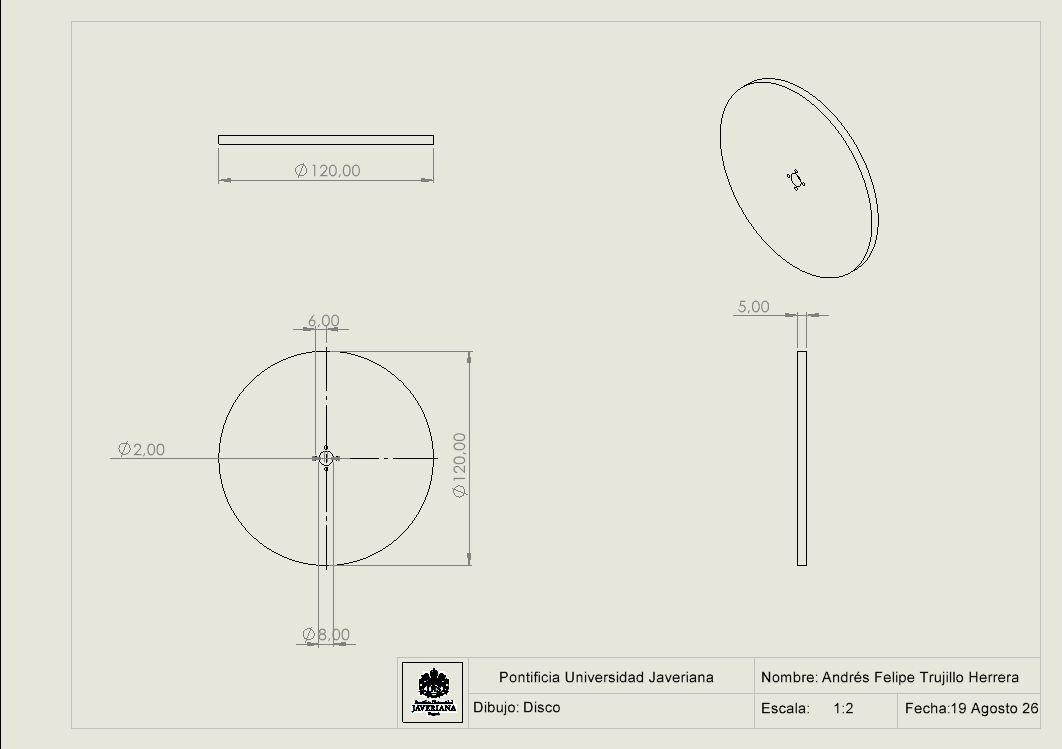
[picture p20: figure]

(a) Plano del disco de freno

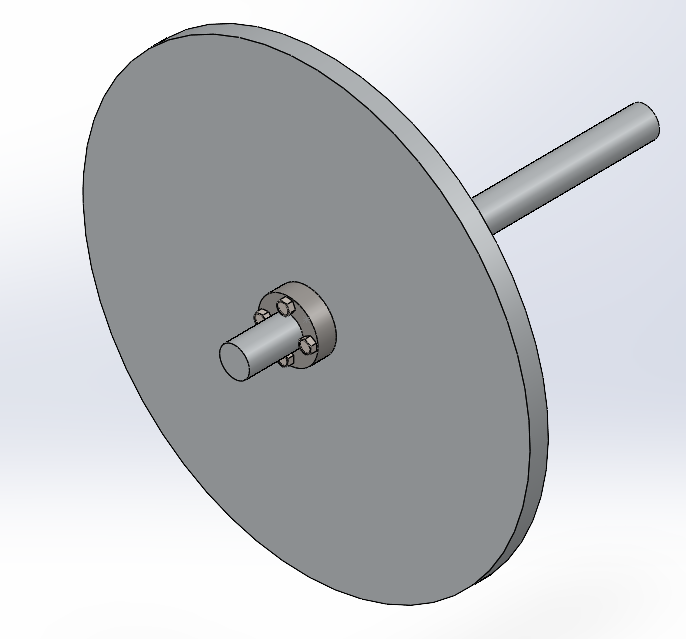
[picture p21: figure]

(b) Ensamble del disco con el eje y las bridas

Figure 5.3: Diseño del disco de freno y su sistema de unión al eje mediante bridas.

5.3 | Diseño de la pinza

La pinza se diseñó como un mecanismo mecánico simétrico de dos brazos, fabricado en aluminio, cuya función es aproximar dos superficies de contacto hacia el disco de frenado. La geometría de la pinza permite que ambas mordazas se acerquen de forma simultánea al disco, favoreciendo una aplicación más uniforme de la carga de frenado.

Cada brazo de la pinza presenta una longitud del orden de 25 a 30 cm, con una sección transversal aproximada de 40 mm × 20 mm, lo cual proporciona una estructura suficientemente rígida para las cargas

5.4 Sistema de ajuste de la carga | Pre Informe (Freno Pinza)

esperadas dentro del banco de pruebas. La selección del aluminio para esta pieza se realizó principalmente por su facilidad de mecanizado, bajo peso y suficiente rigidez para el uso previsto.

La superficie de contacto de cada pastilla con el disco es aproximadamente:

Ap = 40 mm × 20 mm = 800 mm²
. | (5.4)

Esta área permite que la fuerza de contacto se distribuya mejor sobre el disco y evita concentraciones excesivas de presión durante el frenado.

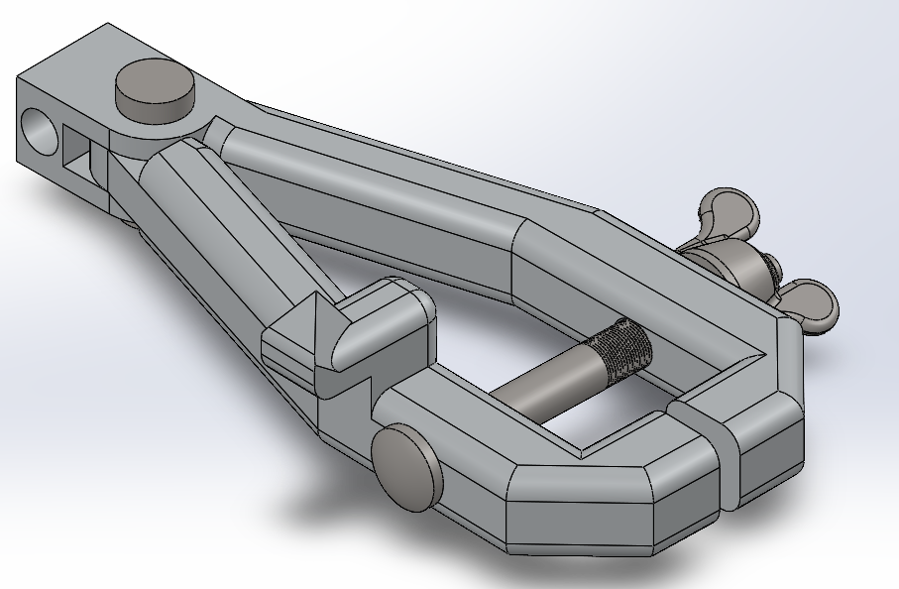
[picture p22: figure]

(a) Vista general del conjunto de la pinza

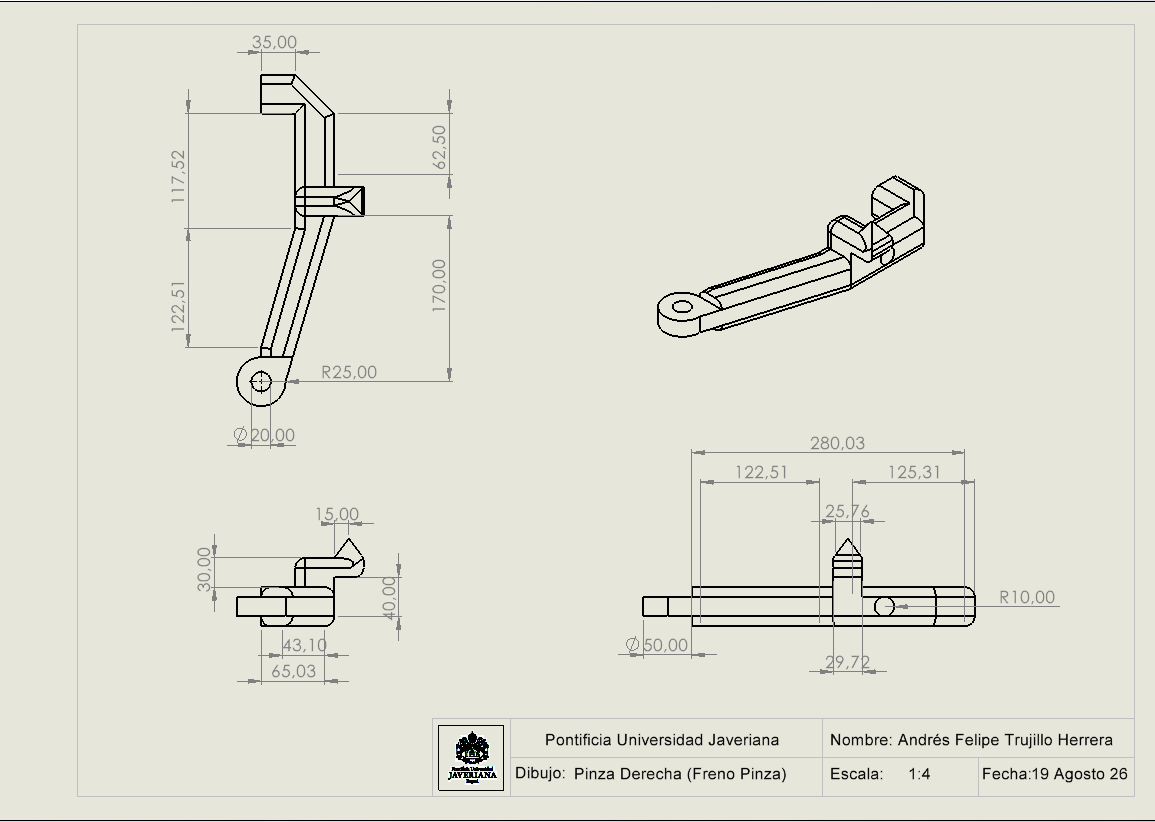
[picture p23: figure]
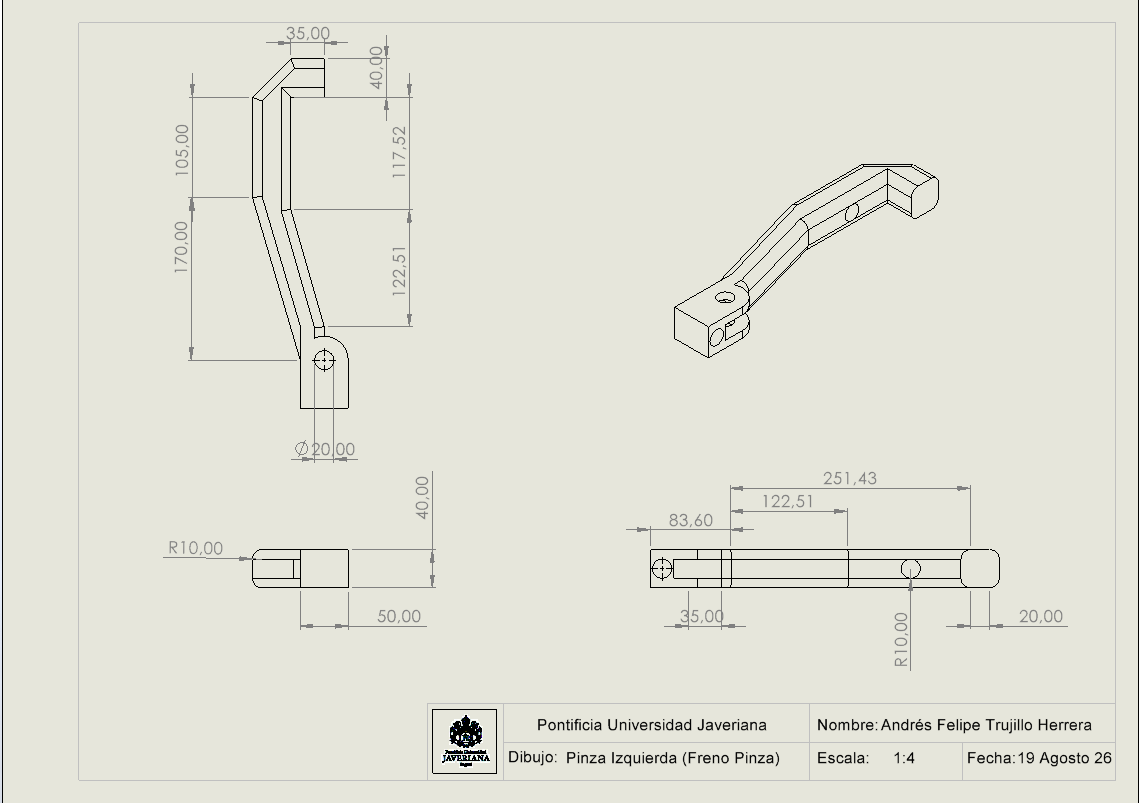
[picture p24: figure]

(b) Plano de la pinza izquierda | (c) Plano de la pinza derecha

Figure 5.4: Diseño general de la pinza de frenado y planos de sus dos brazos.

5.4 | Sistema de ajuste de la carga

La regulación de la carga de frenado se realizó mediante un sistema de ajuste manual basado en una tuerca roscada. Al girar esta tuerca, el mecanismo permite que ambos brazos de la pinza se aproximen o se alejen de forma simétrica con respecto al disco, modificando la fuerza normal aplicada sobre sus dos caras.

Este mecanismo permite variar progresivamente la carga mecánica aplicada al motor. A medida que aumenta el apriete de la pinza, también aumenta la fuerza normal entre el material de fricción y el disco,

5.5 Sistema de medición de torque | Pre Informe (Freno Pinza)

generándose una mayor fuerza de fricción tangencial y, en consecuencia, un mayor torque resistente sobre el eje.

De manera cualitativa, este comportamiento puede representarse como:

N ↑ ⇒ | Fr ↑ ⇒ | TL ↑ . | (5.5)

donde N corresponde a la fuerza normal de contacto, Fr a la fuerza de fricción tangencial y TL al torque de carga aplicado al motor.

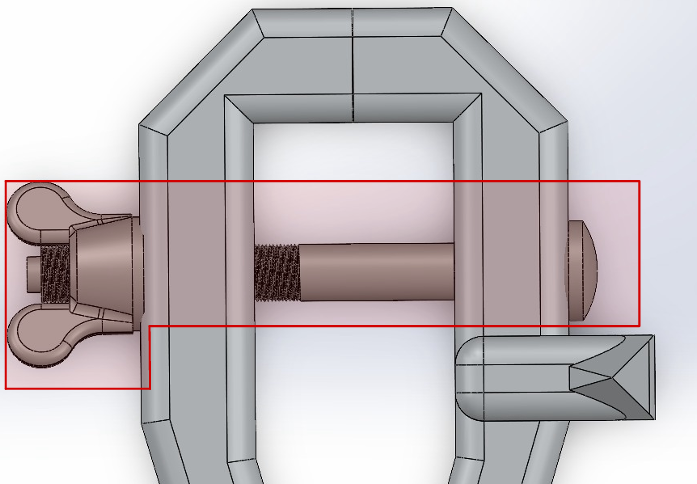
[picture p25: figure]

Figure 5.5: Sistema de ajuste manual de la carga mediante una tuerca roscada.

5.5 | Sistema de medición de torque

El sistema de medición del torque se diseñó aprovechando la reacción mecánica producida sobre la pinza durante el frenado. Cuando las superficies de fricción entran en contacto con el disco en movimiento, este ejerce una fuerza tangencial Fr sobre la pinza. Como consecuencia, el cuerpo de la pinza tiende a girar ligeramente alrededor de su punto de apoyo.

Para detectar esta reacción se incorporó una punta en la parte superior del cuerpo de la pinza. Dicha punta entra en contacto con un elemento instrumentado con galga extensiométrica, ubicado sobre una columna vertical independiente. Cuando la pinza tiende a levantarse, la punta presiona la zona deformable del sensor, generándose una fuerza de contacto denominada Fm.

El elemento instrumentado posee una zona de aproximadamente 3 mm de espesor que trabaja como un pequeño voladizo. De esta forma, el incremento de la carga de frenado produce una mayor fuerza Fm y, por consiguiente, una mayor deformación del elemento sensor.

En esta sección se analiza únicamente la relación mecánica entre la fuerza medida y el torque de carga. El acondicionamiento de la galga extensiométrica, su calibración y la relación entre la deformación y la señal eléctrica se desarrollan posteriormente en el apartado correspondiente al sistema de sensores.

5.5 Sistema de medición de torque | Pre Informe (Freno Pinza)

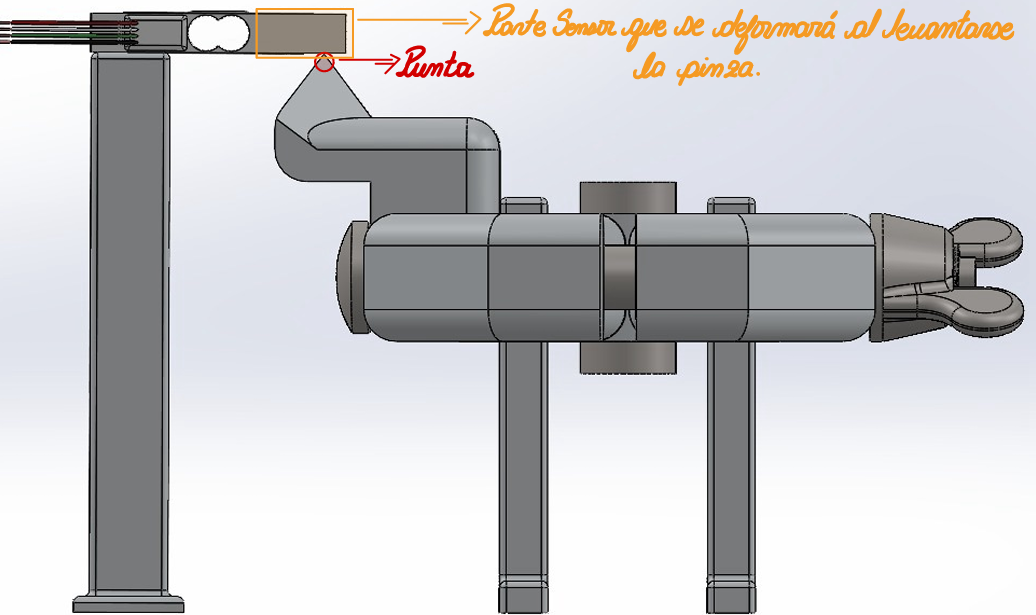
[picture p26: figure]

Figure 5.6: Detalle del sistema de medición de torque mediante el contacto entre la punta de la pinza y el elemento instrumentado con galga extensiométrica.

5.5.1 | Convención de coordenadas y signos

Para realizar el análisis de fuerzas y momentos se definió un sistema coordenado común para los diagramas de cuerpo libre. Este sistema permite establecer de forma consistente la dirección positiva de las fuerzas y el sentido de los momentos mediante la regla de la mano derecha.

En el análisis se tomó como positivo el sentido del momento producido por la fuerza de fricción Fr sobre la pinza, mientras que el momento producido por la fuerza medida Fm se consideró en sentido contrario. Esta convención se mantiene durante todo el desarrollo mecánico.

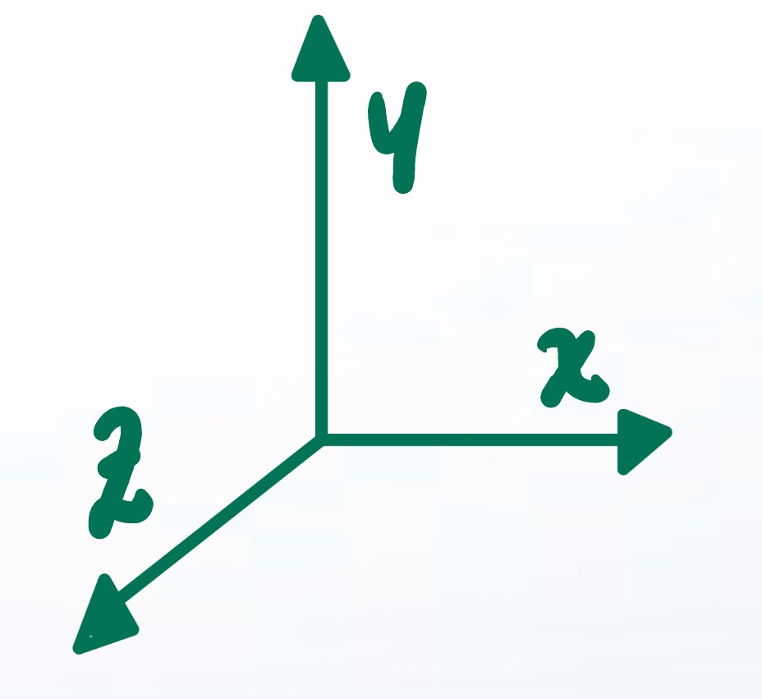
[picture p27: figure]

Figure 5.7: Sistema coordenado utilizado para establecer las direcciones positivas de fuerzas y momentos.

5.5.2 | Diagrama de cuerpo libre de la pinza

Para establecer la relación entre la fuerza medida por el sensor y la fuerza de fricción generada durante el frenado se realizó inicialmente el diagrama de cuerpo libre de una de las pinzas.

La fuerza Fr corresponde a la fuerza de fricción que el disco ejerce sobre la pinza y actúa tangencialmente a la superficie de contacto. Esta fuerza tiende a producir la rotación de la pinza alrededor de su pivote. En sentido contrario actúa la fuerza Fm, correspondiente a la reacción que el elemento instrumentado ejerce sobre la punta de la pinza.

5.5 Sistema de medición de torque | Pre Informe (Freno Pinza)

También aparece la fuerza normal N1, ejercida por el disco sobre la superficie de contacto de la pinza. Esta fuerza es perpendicular al plano del disco y, aunque forma parte del diagrama de cuerpo libre, no interviene directamente en el equilibrio de momentos utilizado para determinar Fr.

Para simplificar el análisis, las distancias dm y dF r se definieron directamente como los brazos perpendicu-lares entre el pivote de la pinza y las líneas de acción de Fm y Fr, respectivamente. De esta forma no es necesario introducir ángulos en el cálculo de los momentos.

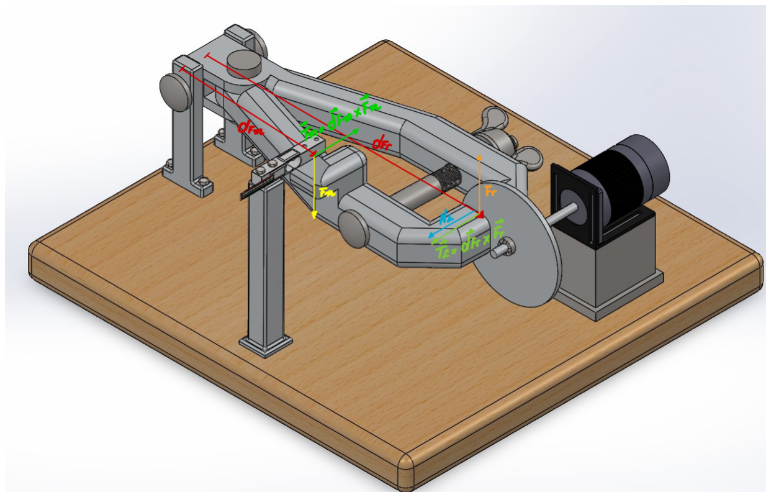
[picture p28: figure]

Figure 5.8: Diagrama de cuerpo libre de la pinza utilizado para relacionar la fuerza medida Fm con la fuerza de fricción Fr.

5.5.3 | Diagrama de cuerpo libre del disco

Posteriormente se realizó el diagrama de cuerpo libre del disco de frenado. Sobre cada una de sus caras actúa la fuerza de fricción producida por la correspondiente pastilla, en sentido contrario al movimiento tangencial de la superficie del disco.

En este análisis, ref representa la distancia perpendicular entre el eje de rotación y la línea de acción de la fuerza de fricción. Este valor corresponde aproximadamente al radio del centro de la superficie efectiva de contacto entre la pastilla y el disco.

La fuerza normal que la pinza ejerce sobre el disco aparece en sentido opuesto a la normal mostrada en el diagrama de la pinza, de acuerdo con el principio de acción y reacción. Para un accionamiento simétrico, las normales aplicadas sobre ambas caras del disco son aproximadamente iguales y opuestas, por lo que no generan un torque alrededor del eje de rotación.

5.6 Cálculos mecánicos | Pre Informe (Freno Pinza)

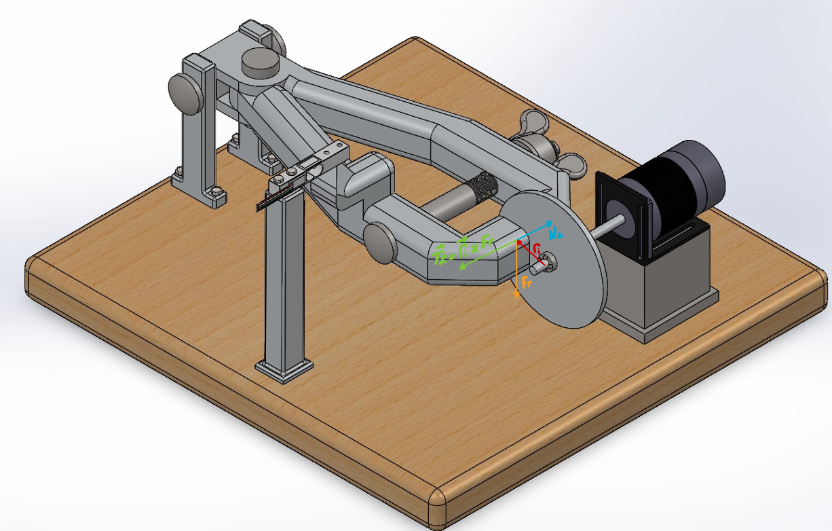
[picture p29: figure]

Figure 5.9: Diagrama de cuerpo libre del disco de frenado y definición del radio efectivo ref.

5.5.4 | Relación entre fuerza medida y torque de carga

Los dos diagramas de cuerpo libre permiten establecer la cadena mecánica de medición utilizada en el banco de pruebas. En primer lugar, la fuerza medida Fm permite determinar la fuerza de fricción Fr mediante el equilibrio de momentos de la pinza. Posteriormente, la fuerza de fricción obtenida permite calcular el torque de carga aplicado al eje a partir del diagrama de cuerpo libre del disco.

Por lo tanto, el principio de medición puede resumirse mediante:

Fm | −→ | Fr | −→ | TL. | (5.6)

La deducción matemática de esta relación se desarrolla en la subsección de cálculos mecánicos.

5.6 | Cálculos mecánicos

A partir de los diagramas de cuerpo libre de la pinza y del disco se desarrolló el procedimiento para obtener el torque de carga TL a partir de la fuerza Fm aplicada sobre el elemento instrumentado.

Para este análisis se consideró que, una vez estabilizado el sistema durante cada medición, la pinza se encuentra en equilibrio rotacional. Por lo tanto, su aceleración angular puede aproximarse como cero:

αpinza ≈ 0, | (5.7)

y en consecuencia:

XT = 0. | (5.8)

5.6 Cálculos mecánicos | Pre Informe (Freno Pinza)
5.6.1 | Equilibrio de momentos en la pinza

De acuerdo con el DCL mostrado en la Fig. 5.8, la fuerza de fricción Fr produce un momento alrededor del pivote de la pinza dado por:

TF r = FrdF r, | (5.9)

donde dF r corresponde al brazo perpendicular entre el pivote y la línea de acción de Fr.

Por otra parte, la fuerza medida Fm produce un momento en sentido contrario:

Tm = Fmdm, | (5.10)

donde dm corresponde al brazo perpendicular entre el pivote de la pinza y la línea de acción de Fm.

Tomando como positivo el sentido del momento generado por Fr, el equilibrio rotacional de la pinza puede expresarse como:

XT = FrdF r − Fmdm = 0. | (5.11)

Por lo tanto:

FrdF r = Fmdm. | (5.12)

Despejando la fuerza de fricción se obtiene:

Fr = Fm

dm

dF r

(5.13)

Esta ecuación permite determinar la fuerza tangencial de fricción correspondiente a una de las superficies de frenado a partir de la fuerza detectada por el sistema de medición.

5.6.2 | Torque generado sobre el disco

A partir del DCL del disco mostrado en la Fig. 5.9, el momento generado por la fuerza de fricción correspondiente a una de las pastillas es:

TL,1 = Frref, | (5.14)

donde ref corresponde al radio efectivo de aplicación de la fuerza de fricción.

Debido a que el disco es frenado por dos superficies de contacto y el mecanismo de ajuste fue diseñado para aproximar ambas pinzas de forma simétrica, se asumió:

Fr1 ≈ Fr2 = Fr. | (5.15)

Por lo tanto, ambas fuerzas contribuyen al torque resistente aplicado al eje:

TL = Fr1ref + Fr2ref. | (5.16)

5.6 Cálculos mecánicos | Pre Informe (Freno Pinza)

Bajo la condición de simetría:

TL = 2Frref | (5.17)
5.6.3 | Relación final entre la fuerza medida y el torque de carga

Sustituyendo la Ec. (5.13) en la Ec. (5.17), se obtiene:

TL = 2
Fm

dm

dF r
ref. | (5.18)

Por lo tanto, la expresión final utilizada para determinar el torque de carga a partir de la fuerza medida es:

TL = 2Fm

dm

dF r

ref | (5.19)

La consistencia dimensional de la expresión puede verificarse mediante:

[N]

[m]
[m]
[m] = [N m], | (5.20)

confirmando que el resultado corresponde a unidades de torque.

Para la geometría definitiva del banco, los brazos de las fuerzas y el radio efectivo de contacto se obtuvieron directamente a partir del modelo CAD. Los valores determinados fueron:

dm = 209 mm = 0.209 m, | (5.21)
dF r = 299 mm = 0.299 m, | (5.22)

y

ref = 20 mm = 0.020 m. | (5.23)

donde dm corresponde al brazo perpendicular de la fuerza medida Fm, dF r al brazo perpendicular de la fuerza de fricción Fr, ambos medidos respecto al pivote de la pinza, y ref al radio efectivo de contacto entre las superficies de frenado y el disco.

A partir de estos parámetros, la relación geométrica del sistema puede agruparse mediante una constante mecánica definida como:

Kmec = 2

dm

dF r

ref. | (5.24)

Sustituyendo los valores obtenidos del modelo CAD:

Kmec = 2
0.209

0.299
(0.020), | (5.25)

obteniéndose:

5.6 Cálculos mecánicos | Pre Informe (Freno Pinza)
Kmec ≈ 0.02796 m | (5.26)

Por lo tanto, la relación final entre la fuerza medida por el sistema y el torque de carga aplicado al motor queda expresada como:

TL = 0.02796 Fm | (5.27)

donde Fm debe expresarse en newtons y el torque de carga TL se obtiene en N m.

Esta expresión constituye la relación mecánica final del sistema de medición, ya que permite determinar el torque resistente aplicado al motor directamente a partir de la fuerza ejercida sobre el elemento instrumentado, teniendo en cuenta la geometría real diseñada para la pinza y el disco.

5.6.4 | Condiciones de torque del motor

Como referencia para el dimensionamiento del sistema se consideró el torque nominal del motor:

Tn = 0.22 N m, | (5.28)

así como el torque máximo teórico obtenido previamente a partir del modelo electromecánico:

Tmax = Tstall ≈ 2.91 N m. | (5.29)

El valor de 2.91 N m corresponde únicamente al límite teórico predicho por el modelo en condición de bloqueo y se emplea como referencia de diseño, no como una condición de operación continua del motor.

A partir de la Ec. (5.17), la fuerza de fricción requerida por cada pastilla para una condición determinada de torque puede calcularse como:

Fr =

TL
2ref
. | (5.30)

Por lo tanto, para la condición máxima teórica:

Fr,max =

Tmax
2ref
, | (5.31)

mientras que para la condición nominal:

Fr,n =

Tn
2ref
. | (5.32)

Finalmente, empleando el equilibrio de la pinza, la fuerza que deberá actuar sobre el elemento instrumentado puede expresarse como:

Fm = Fr

dF r
dm
. | (5.33)

De esta forma, para la condición máxima:

5.7 Selección de materiales | Pre Informe (Freno Pinza)

Fm,max =

TmaxdF r
2refdm

(5.34)

y para la condición nominal:

Fm,n =

TndF r
2refdm

(5.35)

Estas expresiones permiten posteriormente seleccionar y verificar el rango de medición requerido para el elemento instrumentado una vez se conozcan las dimensiones definitivas dm, dF r y ref.

5.7 | Selección de materiales

La selección de materiales se realizó teniendo en cuenta la función mecánica de cada componente, la rigidez requerida, la facilidad de fabricación y la disponibilidad de los materiales. En la Tabla 5.1 se resumen los principales componentes que conforman el banco de pruebas, junto con el material seleccionado, la cantidad requerida y su función dentro del sistema.

Table 5.1: Materiales seleccionados para los componentes del banco de pruebas.

Componente | Material | Cantidad | Función en el sistema
Base estructural | Madera | 1 | Soportar y mantener unidos todos los elementos del banco.
Base del motor | Acero | 1 | Fijar el motor a la base estructural y mantener la alineación del eje.
Soporte de la pinza | Acero | 1 | Sostener el mecanismo de la pinza y mantener su posición respecto al disco.
Pinza de freno | Aluminio | 1 conjunto | Aplicar la fuerza de apriete sobre ambas caras del disco.
Disco de freno | Aluminio | 1 | Recibir la fuerza de fricción y generar el torque resistente sobre el eje.
Base de la galga | Aluminio | 1 | Sostener el elemento instrumentado y permitir su deformación durante la medición.
Celda de carga | Elemento comercial | 1 | Detectar la deformación asociada a la fuerza de reacción del frenado.
Material de fricción | Corcho | 1 | Generar fricción entre la pinza y el disco durante el frenado.
Tornillería | Acero | Varios | Unir y fijar los diferentes componentes mecánicos del sistema.
Base de la pinza | Aluminio | 1 | Servir como elemento de apoyo y unión del mecanismo de la pinza.

La combinación de aluminio, acero y madera permitió obtener una estructura suficientemente rígida para el funcionamiento del banco sin aumentar innecesariamente su masa. El aluminio se utilizó principalmente en los componentes mecanizados del sistema de frenado, mientras que el acero se reservó para los elementos estructurales y de fijación que requieren una mayor rigidez. Por su parte, el corcho se seleccionó como material de fricción para las superficies de contacto entre la pinza y el disco.

## 6 | Sistema de medición y sensores

El sistema de medición se diseñó para obtener las principales variables eléctricas y mecánicas necesarias para caracterizar el motor 57BLDC. Las variables consideradas fueron el voltaje V , la corriente I, la velocidad angular ω y el torque resistente TL.

El voltaje y la corriente se obtienen directamente de la fuente programable, mientras que la velocidad se determina a partir de la salida de pulsos del driver ZS-X11H. Por otra parte, el torque se calcula a partir de la fuerza de reacción medida mediante una celda de carga instrumentada con galgas extensiométricas.

6.1 | Medición de voltaje y corriente

El voltaje de alimentación y la corriente consumida por el motor se obtienen directamente de las mediciones realizadas por la fuente programable Keysight. De esta forma, no es necesario incorporar sensores eléctricos adicionales en el banco de pruebas.

La fuente se comunica con el computador mediante VISA, utilizando Keysight IO Libraries y la librería PyVISA en Python. Esto permite consultar automáticamente los valores de V (t) e I(t) y almacenarlos junto con las demás variables medidas durante cada ensayo.

6.2 Medición de velocidad | Pre Informe (Freno Pinza)
6.2 | Medición de velocidad

La velocidad se obtiene a partir del pin S del driver ZS-X11H, el cual entrega una señal de pulsos relacionada con la velocidad de rotación del motor. El ESP32 recibe esta señal y cuenta el número de pulsos detectados durante un intervalo de tiempo ∆t.

La frecuencia de la señal se determina mediante:

fS =

Npulsos
∆t
, | (6.1)

donde Npulsos corresponde al número de pulsos registrados.

Si Np representa el número de pulsos entregados por cada revolución mecánica del eje, la velocidad puede calcularse como:

n =

60fS
Np
, | (6.2)

y posteriormente:

ω =

2πn
60

=

2πfS
Np

(6.3)

El valor de Np deberá verificarse experimentalmente para el conjunto motor–driver utilizado, debido a que la documentación del ZS-X11H identifica el pin S como una salida de pulsos de velocidad, pero no establece de forma precisa el número de pulsos correspondiente a una revolución. Para ello, la señal puede compararse con una medición de velocidad de referencia y obtener el factor de conversión correspondiente.

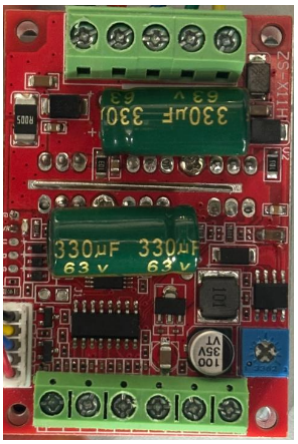
[picture p30: figure]

(a) Driver ZS-X11H y salida de velocidad

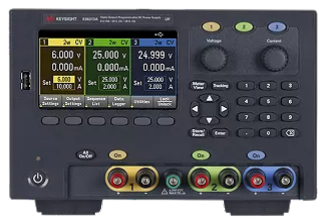
[picture p31: figure]

(b) Fuente programable para medición de V e I

Figure 6.1: Elementos utilizados para obtener las variables eléctricas y la velocidad del motor.

6.3 Medición de fuerza y torque | Pre Informe (Freno Pinza)
6.3 | Medición de fuerza y torque

El torque resistente no se mide directamente. Durante el frenado, la reacción mecánica de la pinza produce una fuerza Fm sobre la celda de carga instalada en el soporte. Esta fuerza genera una pequeña deformación en el elemento instrumentado y, como consecuencia, una variación en la resistencia de las galgas extensiométricas.

Las galgas forman un puente resistivo cuya salida corresponde a un pequeño voltaje diferencial:

Vd = V+ − V−. | (6.4)

Dentro del rango elástico de la celda, esta señal se relaciona con la deformación y, por lo tanto, con la fuerza aplicada. Sin embargo, su amplitud es del orden de milivoltios, por lo que requiere acondicionamiento antes de ser procesada por el ESP32.

6.3.1 | Acondicionamiento y conversión mediante HX711

Para acondicionar la señal de la celda se utiliza el HX711, un convertidor analógico-digital de 24 bits diseñado para trabajar con sensores basados en puentes de galgas extensiométricas.

La señal diferencial Vd ingresa al amplificador de ganancia programable del HX711. En el canal A pueden seleccionarse ganancias de:

G = 128 | o | G = 64, | (6.5)

mientras que el canal B utiliza una ganancia de:

G = 32. | (6.6)

Para este sistema se utilizará el canal A con una ganancia de 128, debido a la baja amplitud de la señal generada por la celda. De manera simplificada, la amplificación puede representarse como:

Vamp = G Vd. | (6.7)

Posteriormente, el convertidor sigma–delta interno transforma esta señal analógica en una lectura digital de 24 bits:

Vd → PGA → ADC de 24 bits → NHX711. | (6.8)

La lectura NHX711 se transmite digitalmente al ESP32, el cual se encarga de aplicar la relación de calibración para convertir este valor en la fuerza Fm expresada en newtons.

El HX711 permite trabajar con tasas de salida de 10 o 80 muestras por segundo. Para las mediciones estacionarias se utilizarán 10 SPS junto con el promedio de varias muestras, mientras que para los ensayos transitorios se emplearán 80 SPS con el fin de registrar con mayor detalle los cambios de fuerza.

6.3 Medición de fuerza y torque | Pre Informe (Freno Pinza)

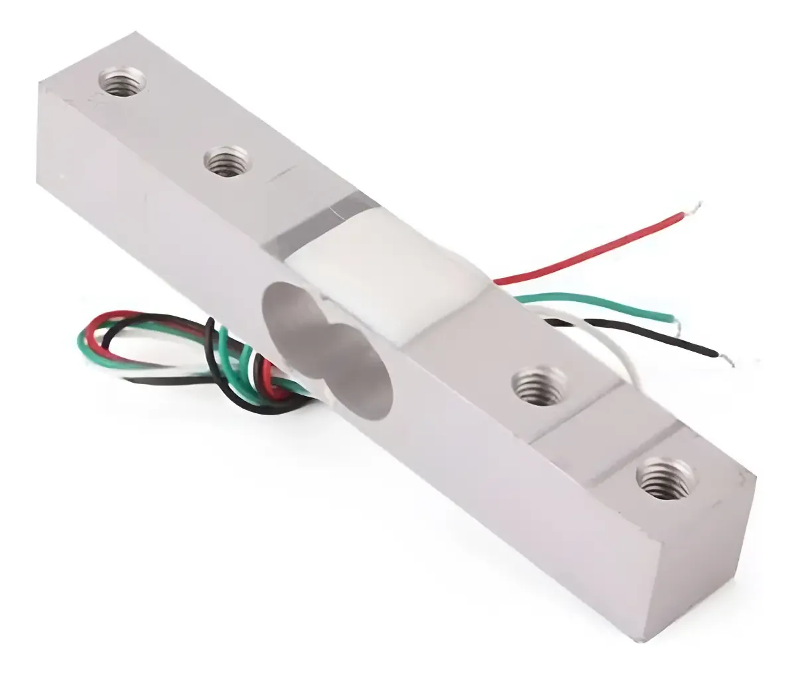
[picture p32: figure]

(a) Celda de carga utilizada para medir Fm

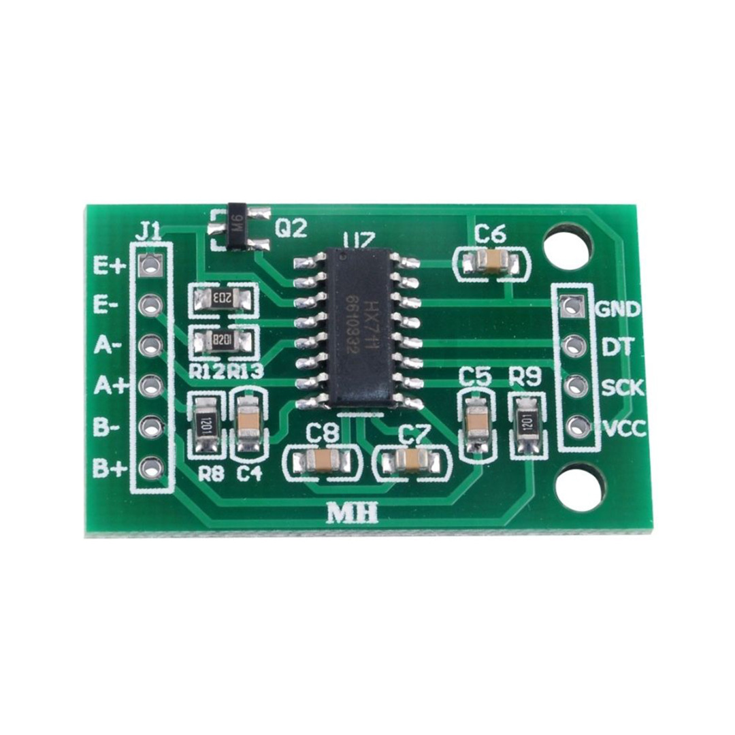
[picture p33: figure]

(b) Módulo HX711 para acondicionamiento y conversión

Figure 6.2: Elementos utilizados para la medición y adquisición de la fuerza de reacción durante el frenado.

6.3.2 | Conversión de la lectura digital a fuerza

La lectura entregada por el HX711 no representa directamente una fuerza en newtons. Por esta razón, antes de realizar los ensayos se debe calibrar el sistema para establecer una relación entre la lectura digital y una fuerza conocida.

Inicialmente se registra una lectura de cero N0 sin aplicar fuerza sobre la celda. Posteriormente se aplican diferentes cargas conocidas y se registra para cada una la lectura NHX711. Si se utilizan masas conocidas, la fuerza de referencia se calcula mediante:

Fref = mg. | (6.9)

Con los pares experimentales:

(NHX711, Fref), | (6.10)

se obtiene el factor de calibración KF . Dentro del rango de trabajo, la relación puede aproximarse mediante:

Fm = KF (NHX711 − N0) | (6.11)

Durante el funcionamiento del banco, el ESP32 recibe continuamente la lectura digital del HX711, resta el valor de cero N0 y aplica el factor KF para obtener la fuerza Fm en newtons.

La calibración debe realizarse aplicando las cargas sobre el mismo punto de contacto utilizado posteriormente por la pinza, ya que cualquier modificación en la posición de la celda o en su montaje puede alterar la relación obtenida.

6.4 Resumen de las variables medidas | Pre Informe (Freno Pinza)
6.3.3 | Obtención del torque de carga

Una vez que el ESP32 obtiene la fuerza Fm, esta se transforma en el torque resistente aplicado al eje utilizando la relación geométrica determinada previamente para el mecanismo:

TL = KmecFm, | (6.12)

donde:

Kmec = 0.02796 m. | (6.13)

Por lo tanto:

TL = 0.02796Fm | (6.14)

con Fm expresada en newtons y TL en N m.

La cadena completa para obtener el torque puede resumirse como:

Vd → HX711 → NHX711 → ESP32 → Fm → TL | (6.15)

De esta forma, la deformación de la celda genera una pequeña señal analógica, el HX711 la amplifica y convierte a formato digital, el ESP32 utiliza la calibración para obtener la fuerza y, finalmente, la geometría del mecanismo permite calcular el torque de carga aplicado al motor.

6.4 | Resumen de las variables medidas

La Tabla 6.1 resume la forma en que se obtiene cada variable utilizada durante la caracterización.

Table 6.1: Variables medidas y método de adquisición.

Variable | Origen | Procesamiento
V | Fuente Keysight | PyVISA
I | Fuente Keysight | PyVISA
n, ω | Pin S del ZS-X11H | Conteo de pulsos
Fm | Celda de carga | HX711 + calibración
TL | Fuerza Fm | TL = 0.02796Fm

## 7 | Protocolo de medición

El protocolo de medición se definió con el propósito de caracterizar experimentalmente el motor 57BLDC bajo diferentes condiciones de alimentación y carga. Durante las pruebas se registran de forma continua el voltaje V , la corriente I, la velocidad de giro n y la fuerza medida Fm. A partir de estas variables se calculan posteriormente la velocidad angular ω, el torque de carga TL, la potencia mecánica y la eficiencia del sistema.

La adquisición continua permite utilizar una misma base de datos tanto para la obtención de curvas características en estado estacionario como para el análisis de las respuestas transitorias ante cambios de voltaje y de torque de carga.

7.1 Preparación del banco y arquitectura de adquisición | Pre Informe (Freno Pinza)
7.1 | Preparación del banco y arquitectura de adquisición

Para realizar las pruebas se emplean el banco mecánico diseñado, el motor 57BLDC, el driver ZS-X11H, la fuente de alimentación programable, la celda de carga, el módulo HX711, el ESP32 y un computador encargado del procesamiento y almacenamiento de los datos.

Antes de iniciar el ensayo se verifica la correcta fijación del motor y de la pinza, la alineación del disco de freno y el libre giro del eje. También se comprueba que la pinza se encuentre inicialmente sin aplicar una carga significativa sobre el disco.

La Fig. 7.1 presenta el montaje general propuesto para el banco de pruebas, incluyendo los elementos mecánicos, electrónicos y de adquisición necesarios para la caracterización del motor.

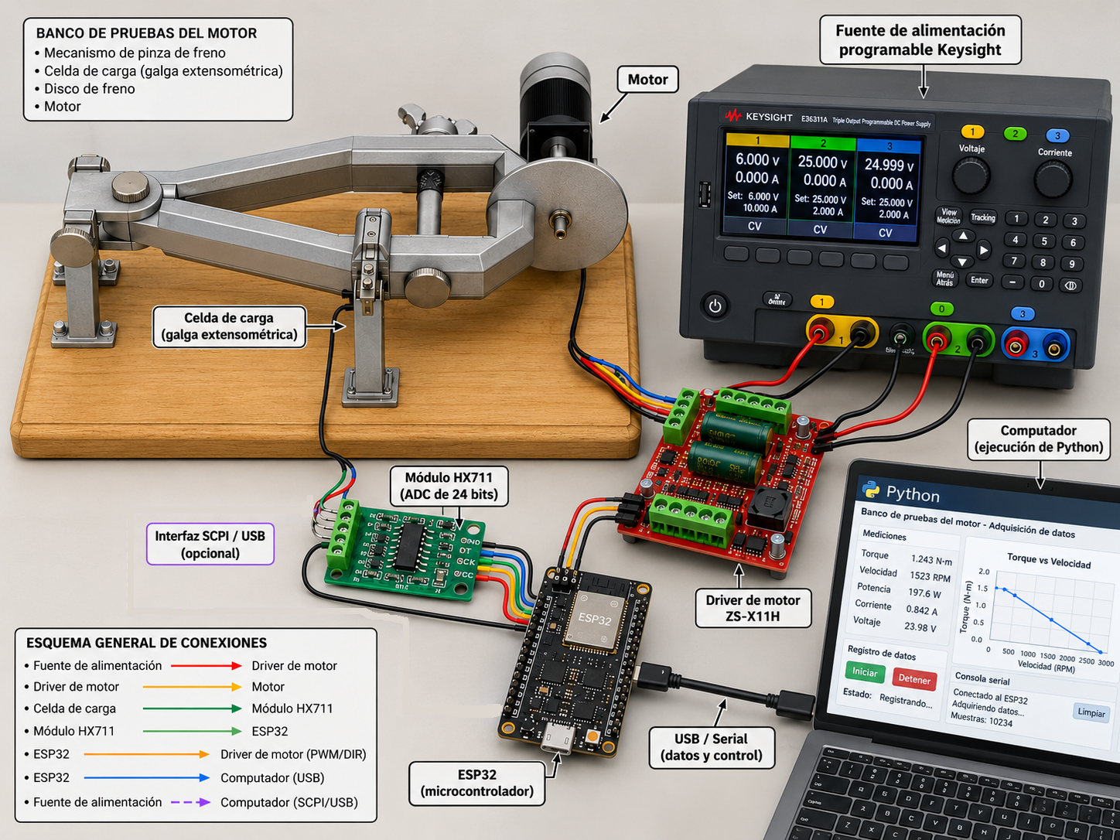
[picture p34: figure]

Figure 7.1: Montaje general del banco de pruebas utilizado para la caracterización experimental del motor.

Además de la verificación mecánica, se valida el correcto funcionamiento de la instrumentación. El ESP32 debe recibir correctamente la lectura digital proveniente del HX711 y la señal del pin S del driver, mientras que el computador debe establecer comunicación con la fuente programable mediante PyVISA y con el broker MQTT para recibir las variables enviadas por el ESP32.

La arquitectura general utilizada para la adquisición, transmisión y procesamiento de los datos se presenta en la Fig. 7.2.

7.2 Calibración y verificación inicial | Pre Informe (Freno Pinza)

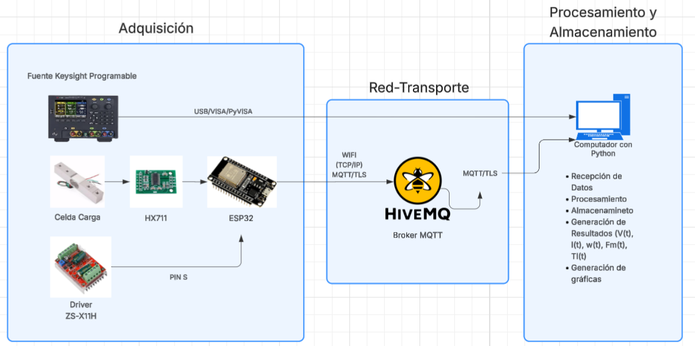
[picture p35: figure]

Figure 7.2: Arquitectura de adquisición, transmisión y procesamiento de las variables del banco de pruebas.

7.2 | Calibración y verificación inicial

Antes de realizar la caracterización se calibra el sistema de medición de fuerza. Primero se realiza la puesta a cero con la pinza sin carga aplicada. Después se aplican cargas conocidas sobre el punto de contacto de la celda y se registra la lectura del HX711 para obtener la relación de calibración entre la lectura digital y la fuerza Fm.

Una vez calibrado el sistema, se realiza una prueba inicial del motor sin carga de frenado, manteniendo la pinza separada del disco. Esta prueba permite verificar el funcionamiento conjunto del motor, el driver, la fuente, la medición de velocidad y la adquisición de datos.

Durante esta etapa se confirma además que el programa en Python reciba y almacene correctamente las variables medidas:

V (t), | I(t), | Fm(t), | n(t). | (7.1)
7.3 | Ejecución del ensayo y registro de datos

Luego de la verificación inicial, se selecciona la condición de alimentación del motor desde la fuente programable. Si se desea estudiar la respuesta transitoria ante cambios de voltaje, este puede modificarse desde Python mediante PyVISA. Para la obtención de curvas características, normalmente se fija un voltaje de alimentación y se modifica progresivamente la carga mecánica.

La carga se aplica manualmente mediante el mecanismo de ajuste de la pinza, aumentando gradualmente el apriete sobre el disco. Cada incremento produce un aumento de la fuerza de reacción medida por la celda de carga y, por lo tanto, un aumento del torque resistente aplicado al motor.

Durante todo el ensayo el ESP32 adquiere la fuerza y la velocidad, mientras que el computador consulta el voltaje y la corriente de la fuente. Todas las mediciones se almacenan junto con su instante de tiempo para conservar tanto la evolución transitoria como los valores estacionarios.

A partir de las variables medidas se calculan:

ω(t) = 2πn(t)
| | 60
| | , | | (7.2)

7.4 Procesamiento de resultados | Pre Informe (Freno Pinza)
TL(t) = 0.02796 Fm(t). | (7.3)

Para construir las curvas características se espera a que las variables se estabilicen en cada condición de operación y se calcula el valor promedio dentro de una ventana de datos. Para el análisis transitorio, en cambio, se utilizan los registros completos en función del tiempo.

7.4 | Procesamiento de resultados

Una vez finalizado el ensayo, los datos se procesan en Python. Para cada punto de operación se cuenta inicialmente con:

V, | I, | n, | Fm. | (7.4)

Con estas variables se calculan la velocidad angular, el torque de carga, la potencia eléctrica de entrada, la potencia mecánica y la eficiencia del motor:

ω =

2πn
60
, | (7.5)
TL = 0.02796 Fm, | (7.6)
Pe = V I, | (7.7)
Pm = TLω, | (7.8)

η =

Pm
Pe
× 100. | (7.9)

Con los valores obtenidos se construyen principalmente las curvas TL − ω, TL − I, TL − Pm y TL − η, además de las gráficas temporales necesarias para el análisis transitorio.

7.5 | Resumen del procedimiento

De manera resumida, el protocolo experimental sigue la secuencia mostrada en la Fig. 7.3.

7.5 Resumen del procedimiento | Pre Informe (Freno Pinza)

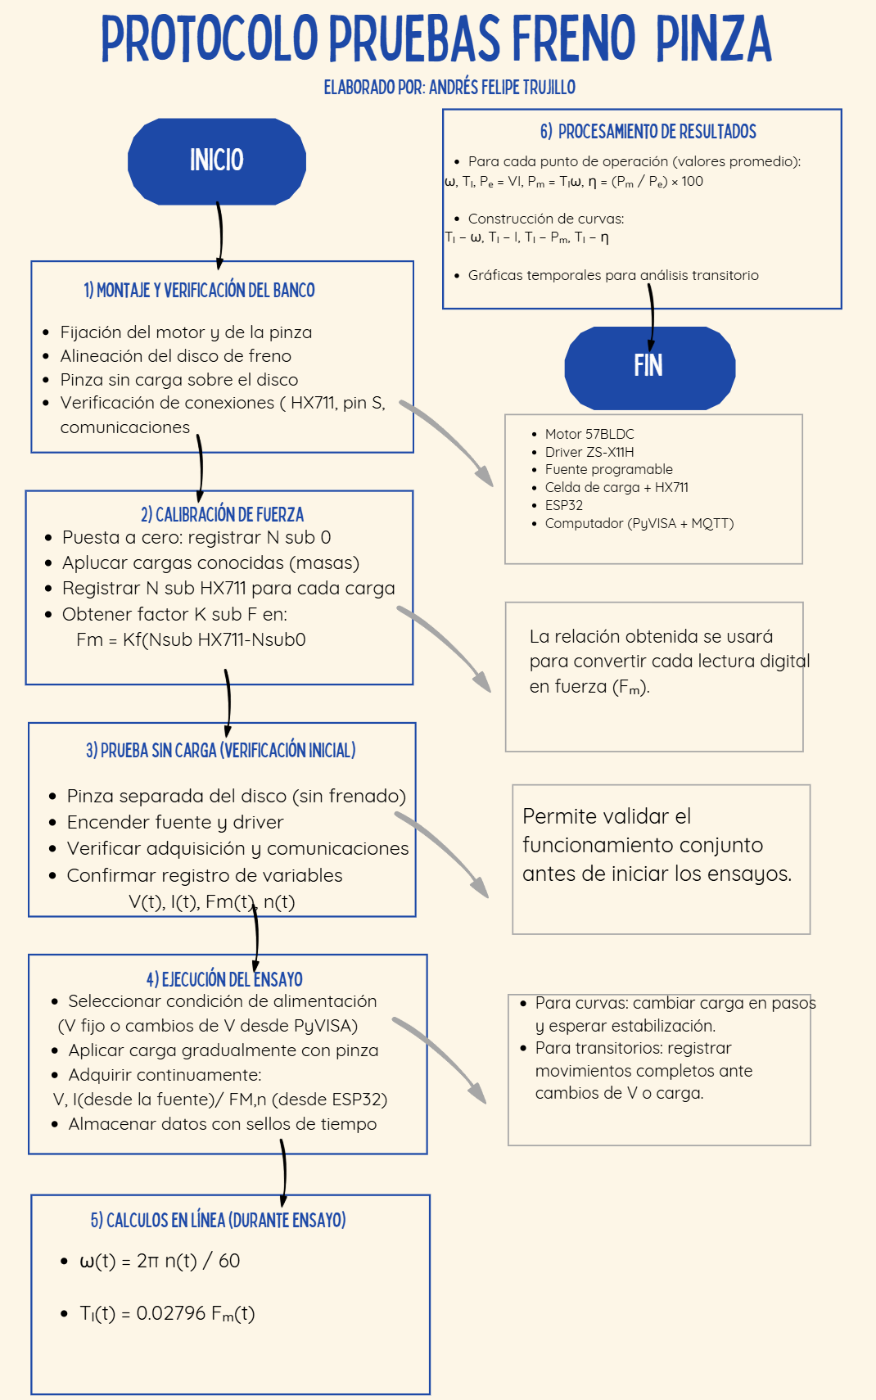
[picture p36: figure]

Figure 7.3: Diagrama de flujo resumido del protocolo de medición.

Pre Informe (Freno Pinza)

## 8 | Conclusiones

■ Se logró establecer un modelo DC equivalente del motor 57BLDC a partir de sus parámetros eléctricos y mecánicos, permitiendo relacionar el voltaje, la corriente, la velocidad y el torque de carga. Su implementación en MATLAB permitió analizar tanto las curvas características en estado estacionario como la respuesta transitoria ante cambios de voltaje y carga.

■ Las simulaciones mostraron que la limitación de corriente de 1 A impuesta por el driver ZS-X11H determina directamente el rango de operación disponible. Aunque el modelo ideal predice un torque de bloqueo de aproximadamente 2.91 N m, con el driver el torque electromagnético máximo se reduce a aproximadamente 0.0583 N m. Para 24 V, la limitación comienza alrededor de TL = 0.0411 N m, por lo que el punto nominal de 0.22 N m no puede alcanzarse con la configuración actual.

■ En las pruebas transitorias se observó que la velocidad aumenta de forma aproximadamente proporcional al voltaje en condición sin carga, alcanzando cerca de 4000 RPM a 24 V. Al aumentar el torque de carga, la corriente crece hasta alcanzar 1 A; a partir de este punto, el motor ya no puede compensar la carga aumentando la corriente y se produce una reducción considerable de la velocidad. La inclusión del disco y los acoples, con Jeq ≈ 2.898 × 10⁻⁴ kg m²
, también permitió
representar de manera más realista la respuesta dinámica del banco.

■ El diseño mecánico desarrollado permite aplicar progresivamente el torque resistente mediante una pinza de freno y medirlo a partir de la reacción producida sobre la celda de carga. El análisis de fuerzas y momentos permitió obtener la relación TL = 0.02796Fm, facilitando la determinación experimental del torque a partir de la fuerza medida sin depender directamente del coeficiente de fricción del freno.

■ Finalmente, se definió un sistema de adquisición que integra la celda de carga con el HX711 y el ESP32, la velocidad obtenida desde el pin S del driver y las mediciones de voltaje y corriente de la fuente programable mediante PyVISA. Junto con el protocolo de calibración, adquisición continua y procesamiento en Python, se dejó establecida la base necesaria para la fabricación del banco y su posterior calibración y validación experimental.

## 9 | Anexos

Junto con el informe se entregan como anexos el modelo CAD completo del banco de pruebas y los planos de fabricación correspondientes a las piezas diseñadas. Estos archivos complementan la información del diseño mecánico presentada en el documento.

Pre Informe (Freno Pinza)

## 10 | Referencias

[1] S. J. Chapman, Electric Machinery Fundamentals. New York, NY, USA: McGraw-Hill, 5 ed., 2012.
[2] R. Krishnan, Permanent Magnet Synchronous and Brushless DC Motor Drives. Boca Raton, FL, USA: CRC Press, 2010.
[3] M. Hein, Demystifying BLDC Motor Commutation: Trap, Sine, and FOC. Texas Instruments, 2021. Material técnico sobre conmutación de motores BLDC.
[4] MathWorks, BLDC: Three-Winding Brushless Direct Current Motor with Trapezoidal Flux Distribution. MathWorks, 2026. Consultado el 3 de agosto de 2026.
[5] MathWorks, DC Motor: DC Motor Model with Electrical and Torque Characteristics. MathWorks, 2026. Consultado el 3 de agosto de 2026.
[6] R. Limpert, Brake Design and Safety. Warrendale, PA, USA: SAE International, 3 ed., 2011.
[7] MOONS’ Industries, Introduction of BLDC Motors. MOONS’ Industries, 2024. Catálogo técnico de motores BLDC, incluida la serie 57BLDC.
[8] J. P. Holman, Experimental Methods for Engineers. New York, NY, USA: McGraw-Hill, 8 ed., 2012.
