szjuan/Micro_1/Case2_Voltage_vs_RPM.png

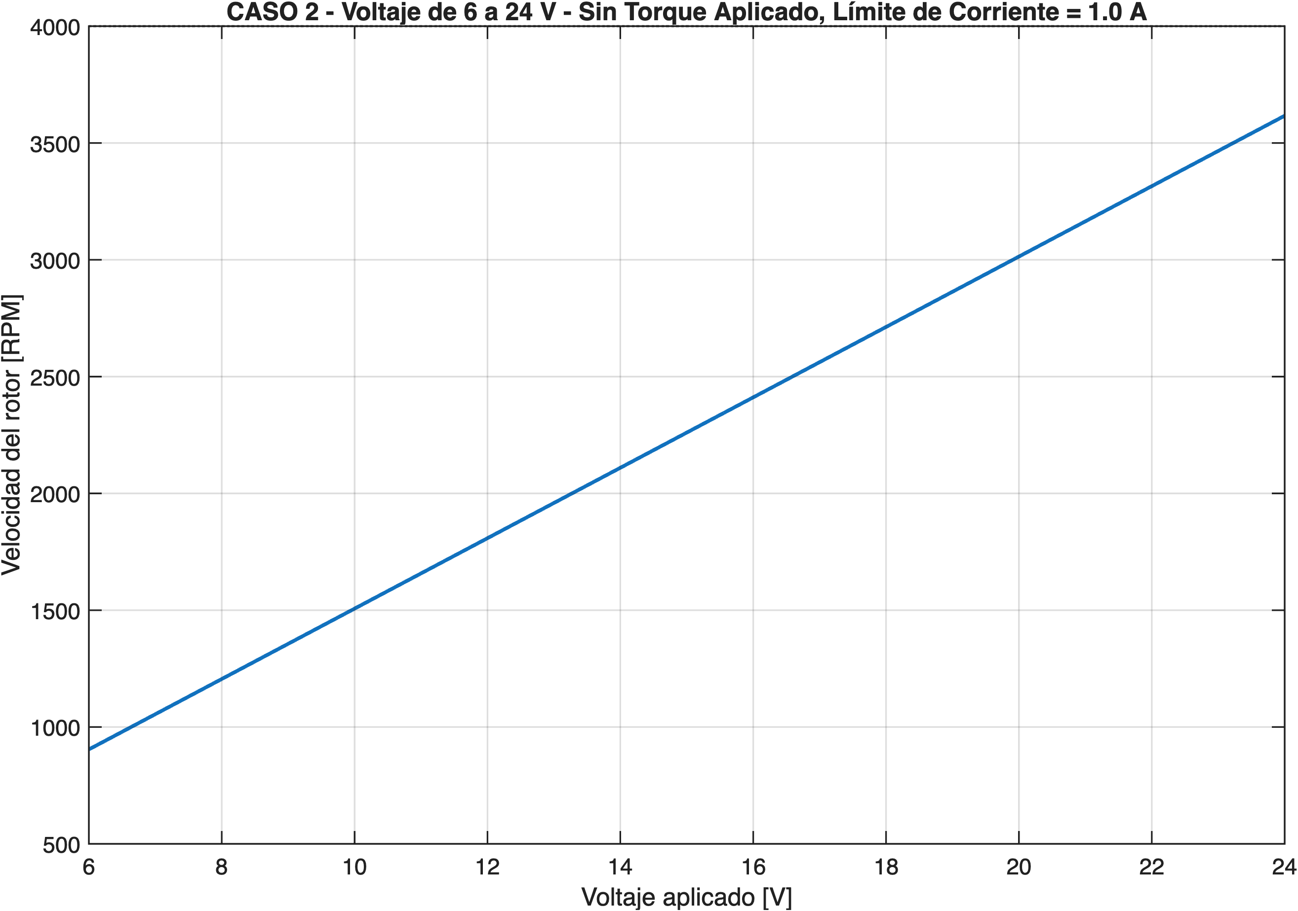
Case2_Voltage_vs_RPM.png
