szjuan/Micro_1/DatosTeoricos/steady_state_results/tiempo_vs_voltaje.csv

t_s | Voltaje
0 | 6
10 | 6
10 | 7
20 | 7
20 | 8
30 | 8
30 | 9
40 | 9
40 | 10
50 | 10
50 | 11
60 | 11
60 | 12
70 | 12
70 | 13
80 | 13
80 | 14
90 | 14
90 | 15
100 | 15
100 | 16
110 | 16
110 | 17
120 | 17
120 | 18
130 | 18
130 | 19
140 | 19
140 | 20
150 | 20
150 | 21
160 | 21
160 | 22
170 | 22
170 | 23
180 | 23
180 | 24
