szjuan/Micro_1/Motor_Simulation_Results.xlsx

Sheet: Motor_Parameters
Parameter | Value | Unit
Motor model | 57BLDC75-20730-08B21 | -
Nominal voltage | 24 | V
Rated speed | 4000 | RPM
Rated torque | 0.22 | N*m
Rated current | 4.8 | A
Rated power | 70 | W
Peak torque | 0.66 | N*m
Peak current | 14.4 | A
Torque constant Kt | 0.06 | N*m/A
Back-EMF constant Ke | 0.06302535746 | V/(rad/s)
Resistance R | 0.48 | ohm
Inductance L | 0.00117 | H
Motor rotor inertia | 1.19e-05 | kg*m^2
External load inertia | 0.00025 | kg*m^2
Total equivalent inertia | 0.0002619 | kg*m^2
Viscous friction coefficient B | 4.297183463e-05 | N*m*s/rad
Number of steady-state points | 3000 | -
Case 1 voltage | 24 | V
Case 1 initial load torque | 0 | N*m
Case 1 final load torque | 0.2 | N*m
Case 1 current limit | 1 | A
Case 1 current limit source | Driver limit | -
Case 2 initial voltage | 6 | V
Case 2 final voltage | 24 | V
Case 2 load torque | 0 | N*m
Case 2 current limit | 1 | A
Case 2 current limit source | Driver limit | -
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
