szjuan/Micro_1/DatosTeoricos/steady_state_results/torque_characteristics.csv

load_torque_Nm | current_A | speed_RPM | effective_voltage_V | mechanical_power_W | electrical_power_W | efficiency_percent | current_limited
0 | 0.2712477396 | 3616.636528 | 24 | 0 | 6.50994575 | 0 | 0
1e-05 | 0.2714135021 | 3616.624473 | 24 | 0.003787320291 | 6.513924051 | 0.05814191664 | 0
2e-05 | 0.2715792646 | 3616.612417 | 24 | 0.007574615334 | 6.517902351 | 0.1162124703 | 0
3e-05 | 0.2717450271 | 3616.600362 | 24 | 0.01136188513 | 6.521880651 | 0.1742117916 | 0
4e-05 | 0.2719107896 | 3616.588306 | 24 | 0.01514912967 | 6.525858951 | 0.2321400108 | 0
5e-05 | 0.2720765521 | 3616.576251 | 24 | 0.01893634897 | 6.529837251 | 0.2899972578 | 0
6e-05 | 0.2722423146 | 3616.564195 | 24 | 0.02272354301 | 6.533815552 | 0.3477836623 | 0
7e-05 | 0.2724080772 | 3616.55214 | 24 | 0.02651071181 | 6.537793852 | 0.4054993537 | 0
8e-05 | 0.2725738397 | 3616.540084 | 24 | 0.03029785536 | 6.541772152 | 0.4631444608 | 0
9e-05 | 0.2727396022 | 3616.528029 | 24 | 0.03408497366 | 6.545750452 | 0.5207191125 | 0
0.0001 | 0.2729053647 | 3616.515973 | 24 | 0.03787206671 | 6.549728752 | 0.5782234371 | 0
0.00011 | 0.2730711272 | 3616.503918 | 24 | 0.04165913452 | 6.553707052 | 0.6356575627 | 0
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
