szjuan/Micro_1/Case1_LoadTorque_Characteristics.png

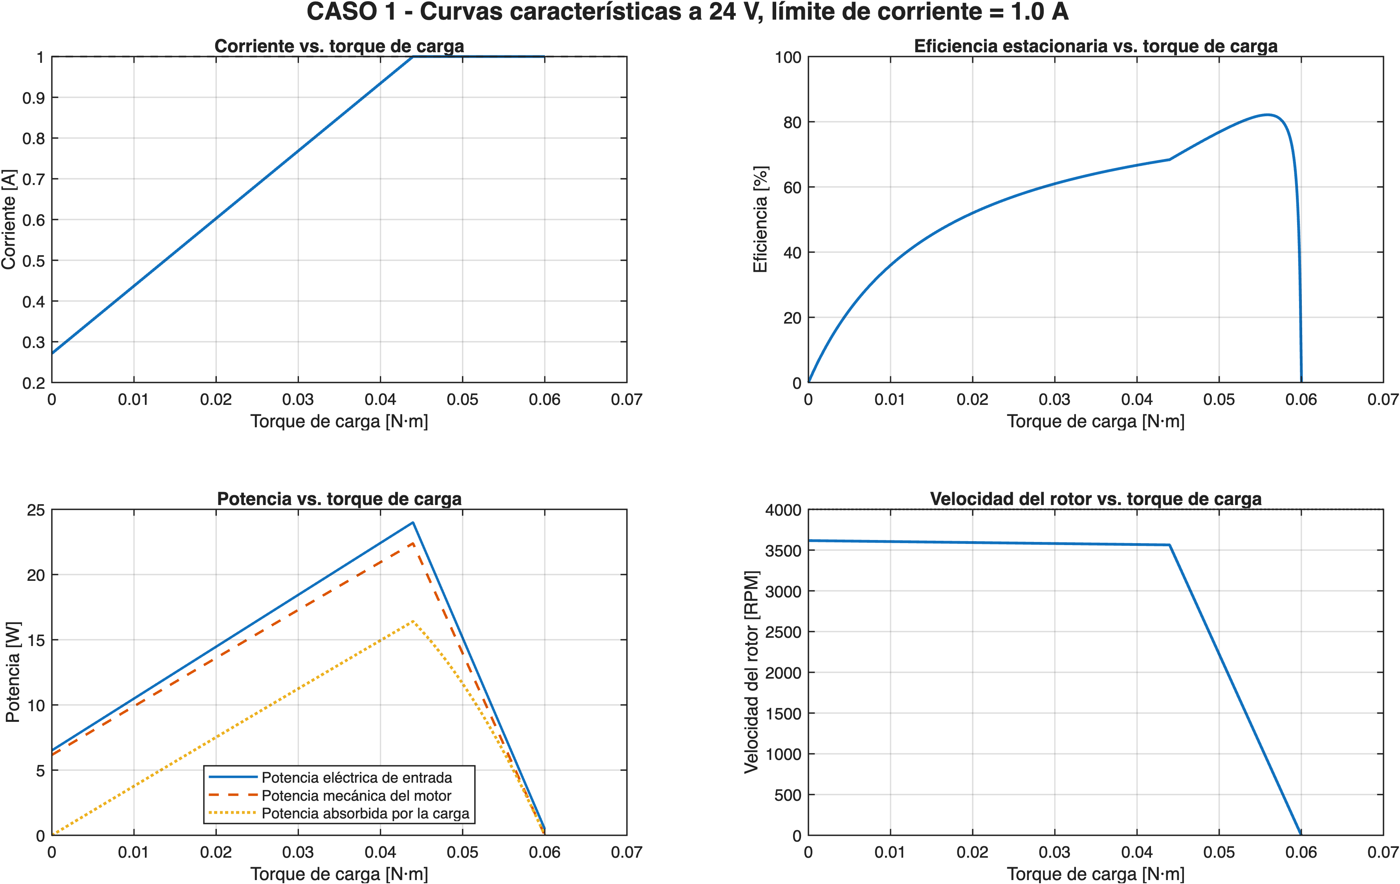
Case1_LoadTorque_Characteristics.png
