szjuan/Micro_1/DatosTeoricos/steady_state_results/motor_characteristics_vs_torque.png

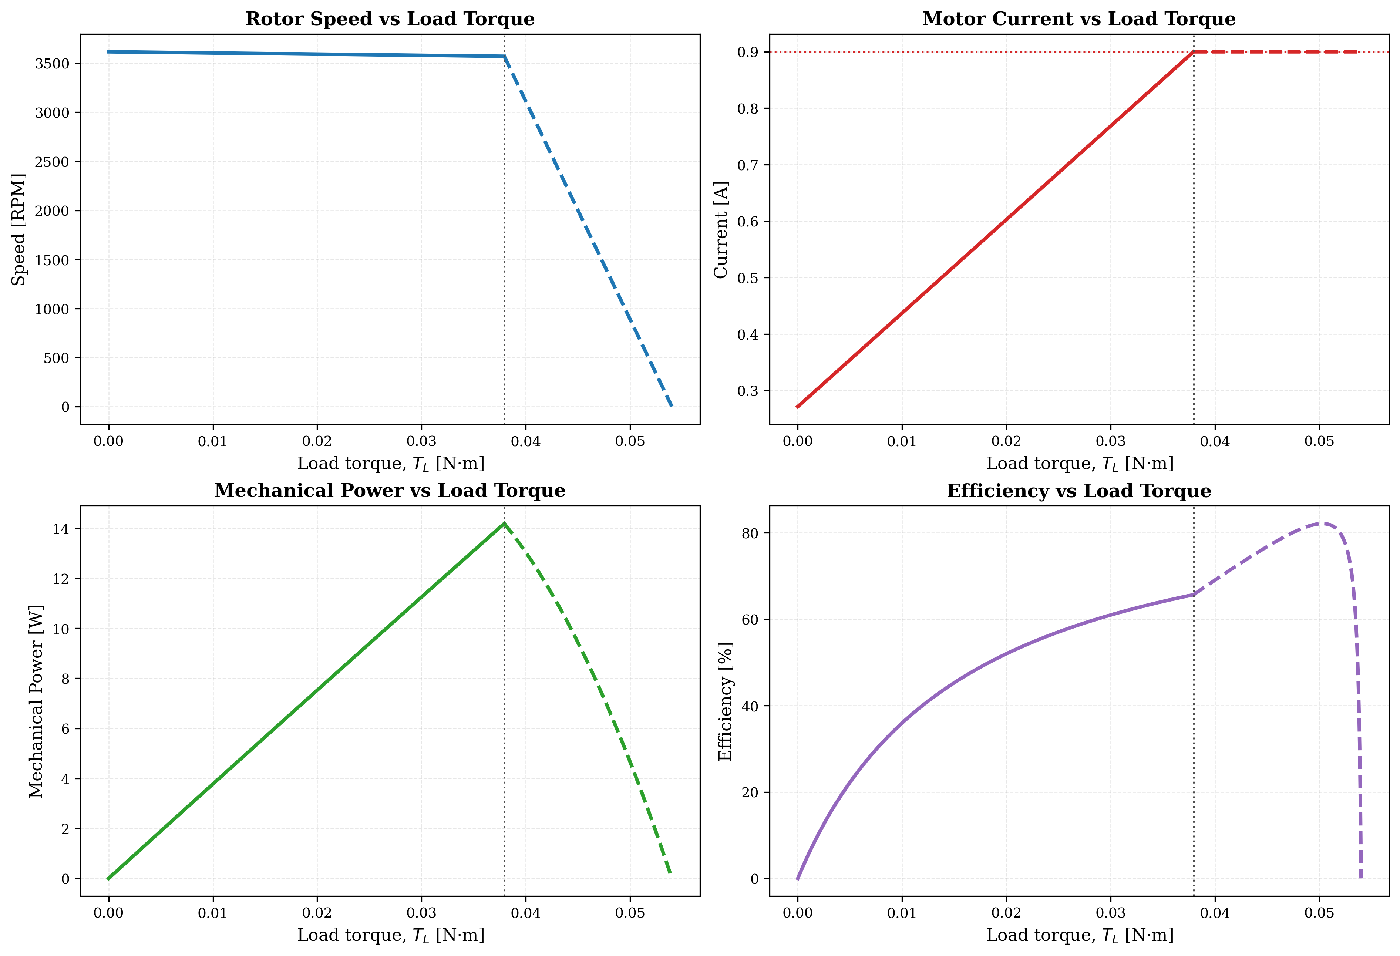
DatosTeoricos/steady_state_results/motor_characteristics_vs_torque.png
