szjuan/Micro_1/DatosTeoricos/steady_state_results/speed_vs_voltage.png

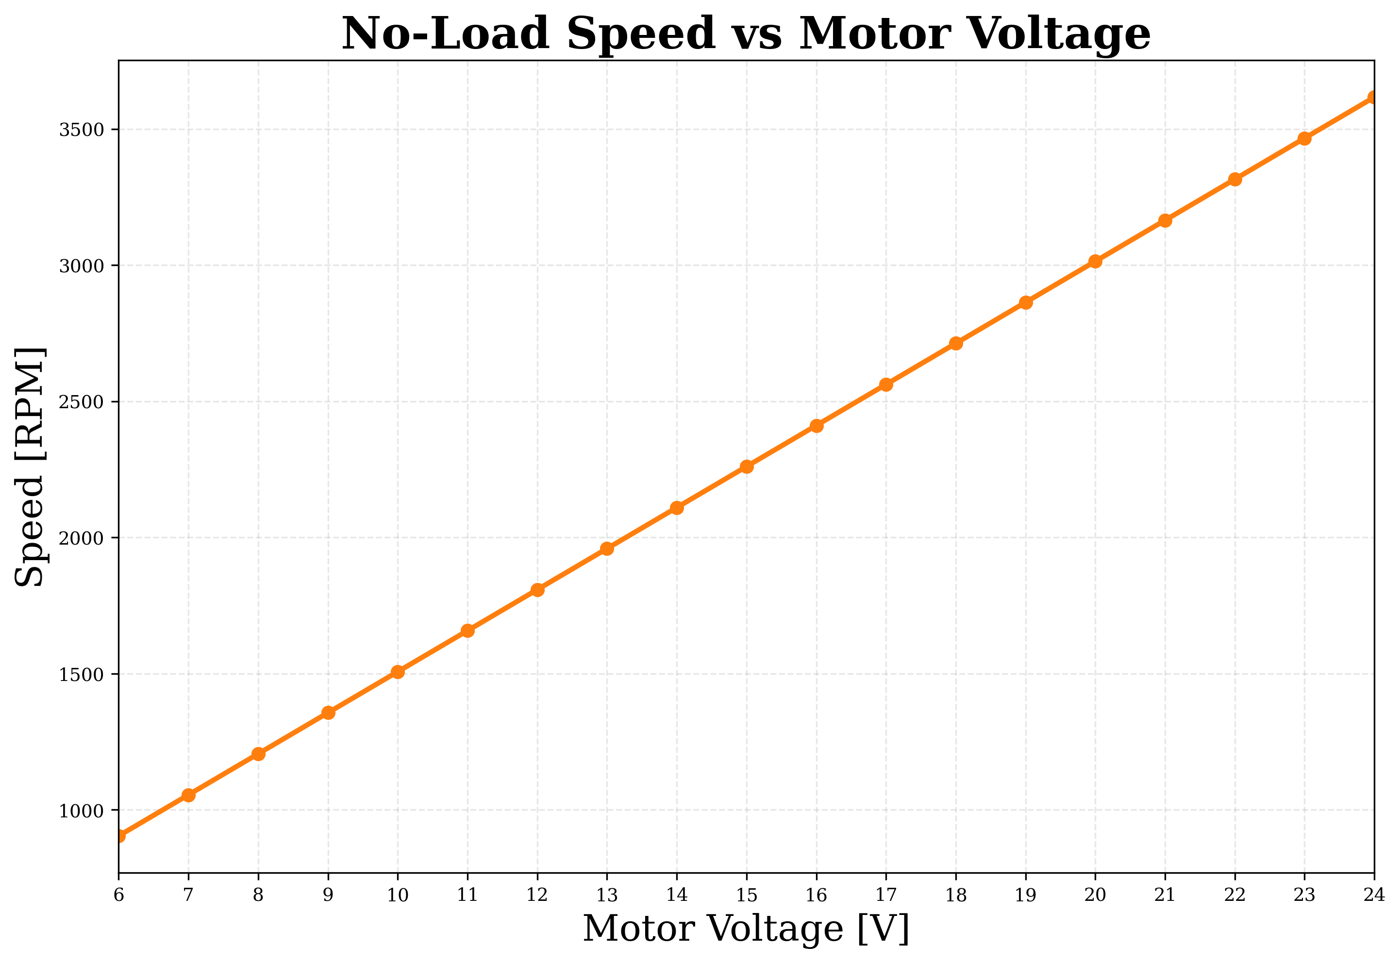
DatosTeoricos/steady_state_results/speed_vs_voltage.png
