szjuan/Micro_1/DatosTeoricos/steady_state_results/voltaje_vs_tiempo.png

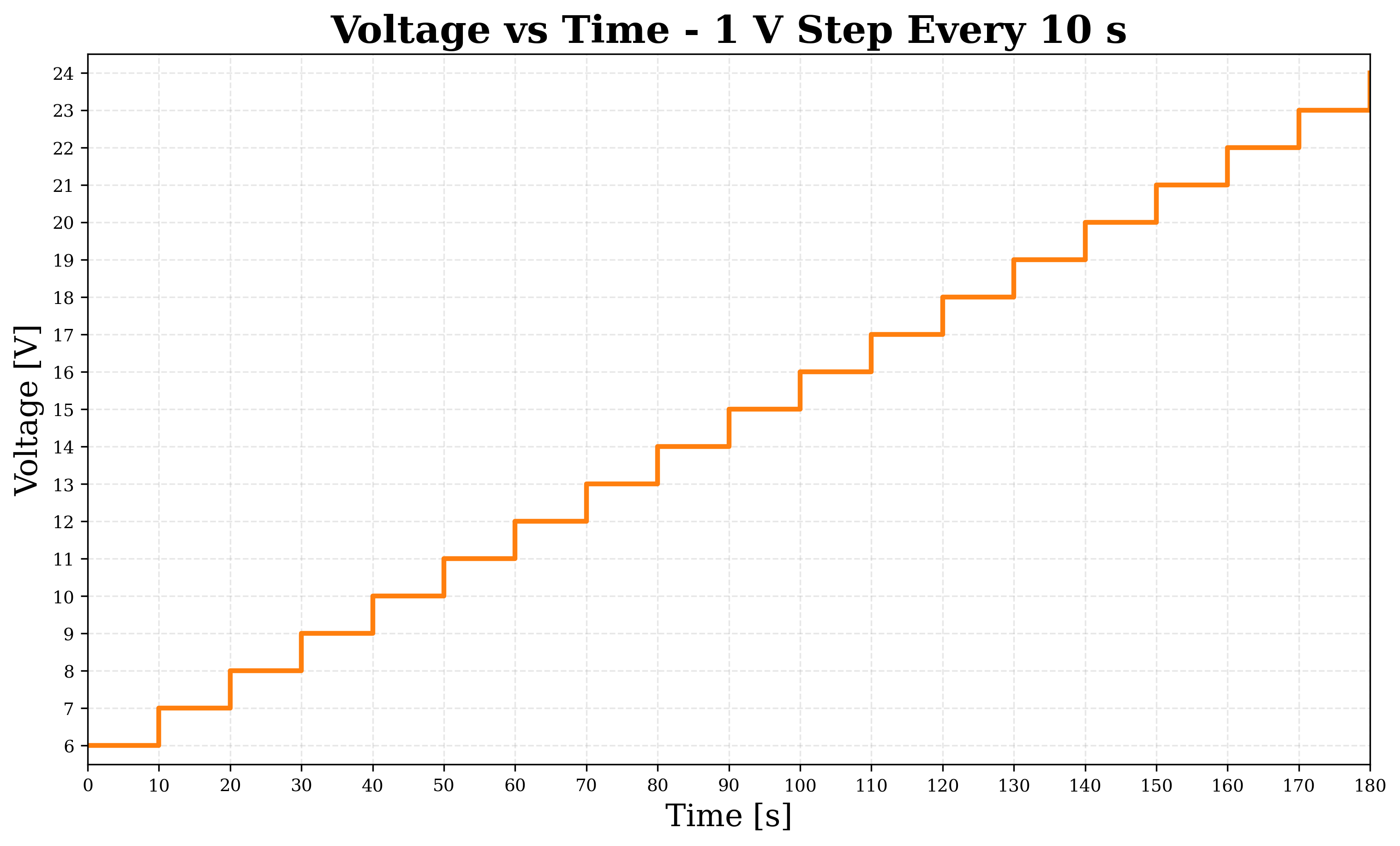
DatosTeoricos/steady_state_results/voltaje_vs_tiempo.png
