szjuan/Micro_1/(commit log)

2026-09-01 primeros archivos.
    [Motor_Simulation_Results.xlsx]
2026-09-02 Actualización del Sistema, migración a HVMQ e implementación de nuevas interfaces y creación de tópico extra
2026-09-02 Refactorización del Dashboard y adición de Graficas.py para generación de curvas características. Se actualizan nombres de variables y se mejora el procesamiento de datos. Se implementan nuevas funci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
2026-09-02 Actualización de credenciales MQTT y mejora en la configuración de seguridad TLS en el Dashboard.
2026-09-02 Implementación de funciones para control de voltaje y manejo de escalones en el Dashboard. Se añade notificación de estado de tara desde el ESP32 a través de MQTT, mejorando la comunicación entre dis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
2026-09-02 Mejora en el proceso de calibración del ESP32. Se implementa un estado de calibración que permite iniciar mediciones solo después de una tara exitosa, y se actualiza la notificación de estado en el S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
2026-09-02 Mejora en el proceso de calibración del ESP32. Se añade un tiempo de espera para la confirmación de la tara y se actualiza la lógica de notificación en el Serial, asegurando que el proceso de calibra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
    [Dashboard.py]
2026-09-02 Corrección de nombre de red WiFi en el archivo ESP32.ino, ajustando la capitalización de "iPhone de Andrés Felipe".
2026-09-02 Implementación del archivo ESP32.ino, que incluye la configuración de WiFi y MQTT, calibración de galga, y lógica para el manejo de RPM y filtrado Kalman. Se establecen pines y se añaden funciones pa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
2026-09-03 Enhancements to the Dashboard.py for improved UI and functionality. Added QStackedWidgets for dynamic panel management, implemented dual graphing capabilities for two test scenarios, and refined data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
2026-09-03 Calculos teoricos y las tablas en csv.
    Calculos teoricos y las tablas en csv.
    [tiempo_vs_rpm.csv, tiempo_vs_voltaje.csv, torque_characteristics.csv, voltage_speed_characteristic.csv]
2026-09-03 Add reset functionality and enhance data handling in Dashboard.py
    Introduced a new function to reset time and clear buffers at the start of tests. Updated the button click behavior to activate the test and display theoretical curves only when the test is active. Improved CSV import functionality to store theoretical data without immediate graphing. Enhanced the overall structure for better data management during experiments.
    [Dashboard.py]
2026-09-03 Graficas y datos teoricos
    Graficas y datos teoricos
    [tiempo_vs_rpm.csv, tiempo_vs_voltaje.csv, voltage_speed_characteristic.csv]
2026-09-03 Add Dashboard_SinFuente.py for monitoring system and enhance Dashboard.py with point capture functionality
    Introduced a new script, Dashboard_SinFuente.py, for monitoring a magnetic brake system without programmable source. Enhanced Dashboard.py by adding point capture features for Test 2, including UI elements for duration selection and progress updates. Improved data handling and signal management for real-time updates during the capture process.
2026-09-03 Refactor torque calculations in ESP32.ino for clarity and accuracy
    Updated torque calculation logic to improve readability and correctness. Introduced constants for distances between components, enhancing the understanding of the physical relationships in the system. Adjusted comments for clarity and consistency, ensuring better documentation of the code's functionality.
    [ESP32.ino]
2026-09-03 Camios en dashboard sin grafica
    [corriente.csv, eficiencia.csv, potencia_mecanica.csv, velocidad.csv]
2026-09-03 Arregalr plot de las graficas teoricas en el dashboard.
2026-09-03 Cambios en la esp32 sin filtro kalman.
2026-09-03 Update WiFi credentials in ESP32.ino for improved connectivity
2026-09-03 Datos Teorico
    [eddy_brake_fem_database.csv]
2026-09-03 cambiso en los datos de CSV
    [eddy_brake_fem_database.csv]
2026-09-03 Cambios en el csv
    Cambios en el csv
2026-09-03 Enhance Dashboard.py with new features for Test 2 data capture
    Updated the Dashboard.py to include additional functionality for capturing data points in Test 2, incorporating distance measurements and theoretical torque calculations. Introduced methods for loading FEM data from a CSV file and performing bilinear interpolation for torque values. Adjusted comments and variable names for clarity, and ensured the current limit is set during voltage adjustments. Updated the VISA address for the programmable source.
